fengecho/electronic/README.md

All work in this repository is under the license bsd available [here] (https://github.com/echopen/electronic/blob/master/LICENSE)

# electronic

This repository is dedicated to the electronic part. The electronic shemas of the modules printed with kicad can be found in the kicad repository
