fengecho/electronic/Mecanics/Readme.md

In this repository one can find the sources of mecanical parts we have printed in order to make a experimental device with an aquarium.
