fengecho/electronic/kicad/Daugter_boards/DB_Envelope_detector/V2/Scheme.png

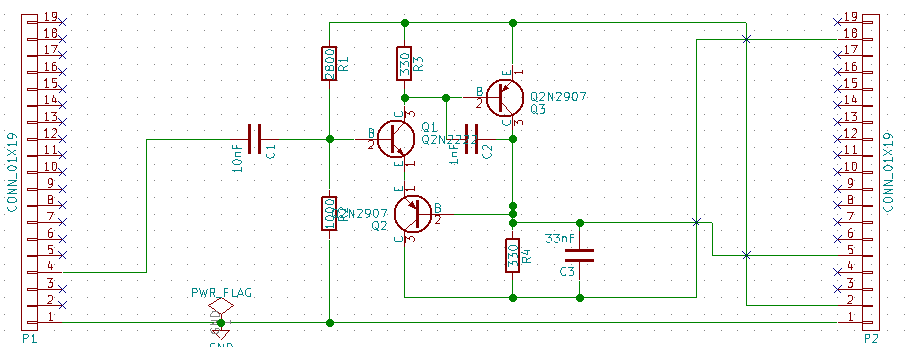
kicad/Daugter_boards/DB_Envelope_detector/V2/Scheme.png
