fengecho/electronic/kicad/Daugter_boards/DB_Filter/V2/Scheme.png

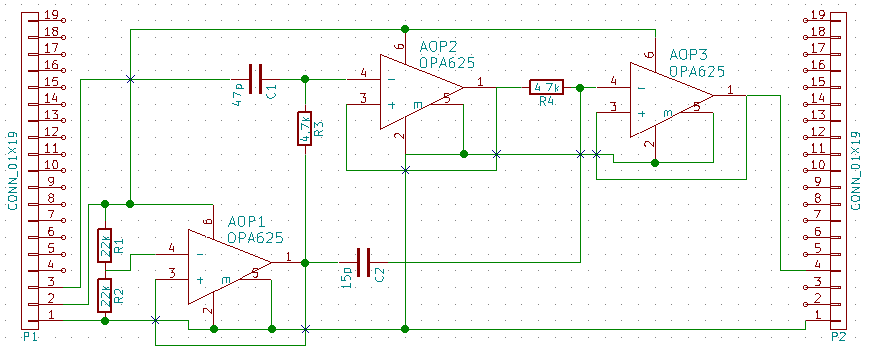
kicad/Daugter_boards/DB_Filter/V2/Scheme.png
