fengecho/electronic/kicad/Daugter_boards/DB_High_Voltage/V2/PCB.png

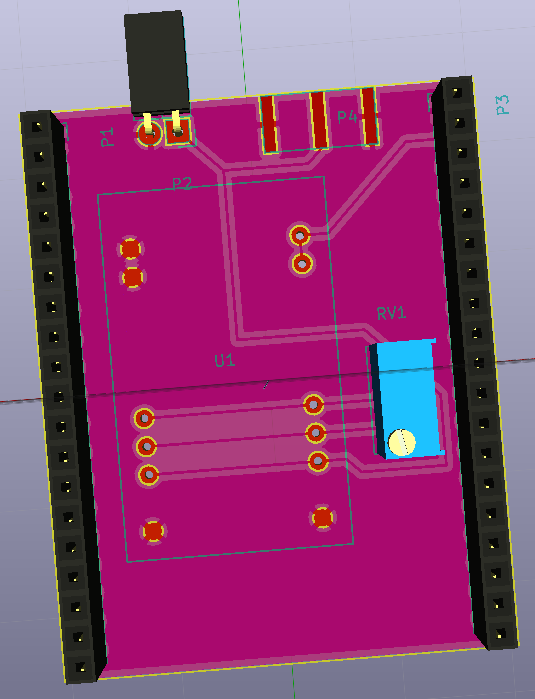
kicad/Daugter_boards/DB_High_Voltage/V2/PCB.png
