fengecho/electronic/kicad/Daugter_boards/DB_High_Voltage/V2/Scheme.png

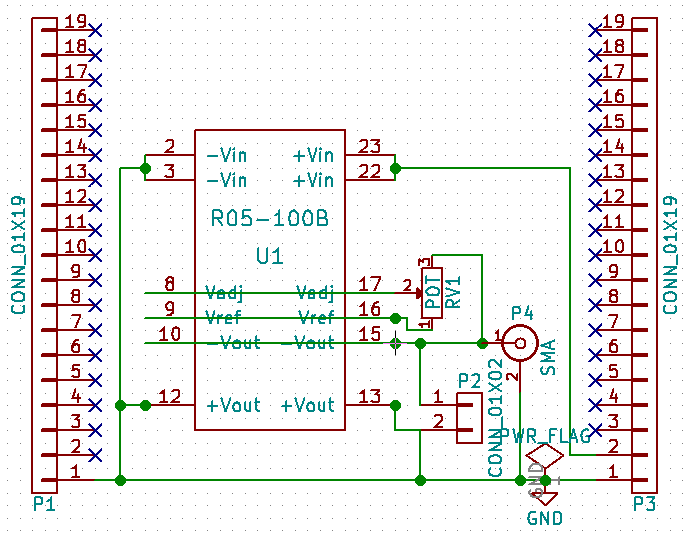
kicad/Daugter_boards/DB_High_Voltage/V2/Scheme.png
