fengecho/electronic/kicad/Daugter_boards/DB_Motor_control/V2/PCB.png

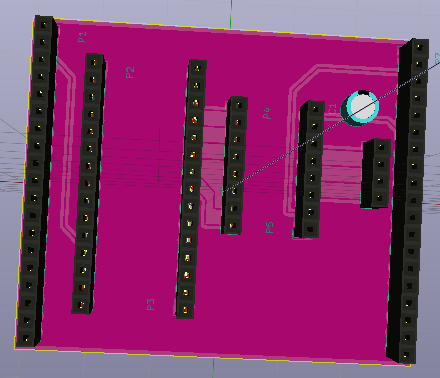
kicad/Daugter_boards/DB_Motor_control/V2/PCB.png
