fengecho/electronic/kicad/Daugter_boards/DB_Motor_control/V2/Scheme.png

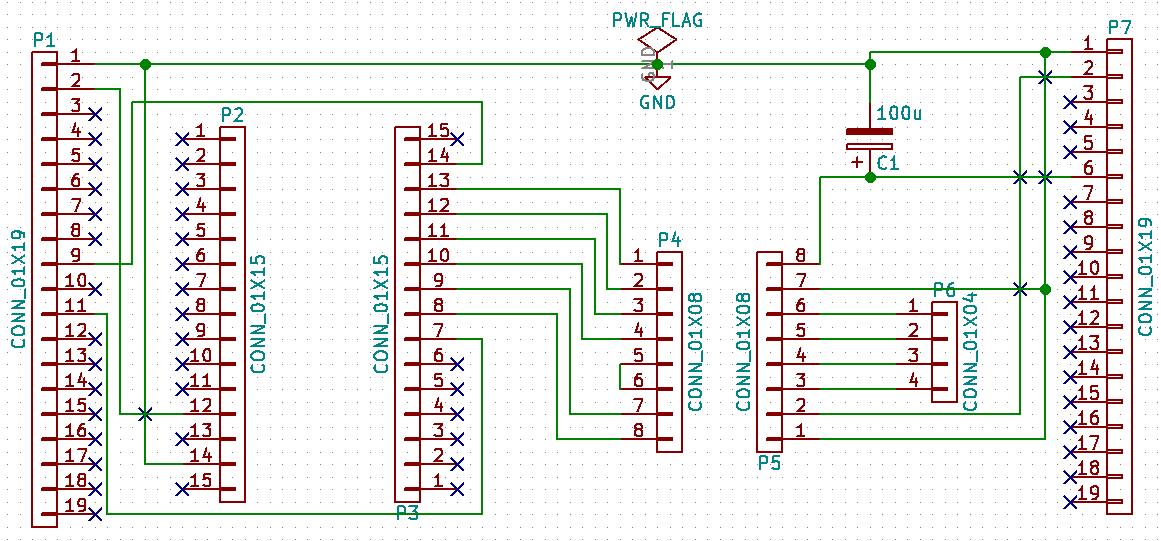
kicad/Daugter_boards/DB_Motor_control/V2/Scheme.png
