fengecho/electronic/kicad/Daugter_boards/DB_Supply/V2/Scheme.png

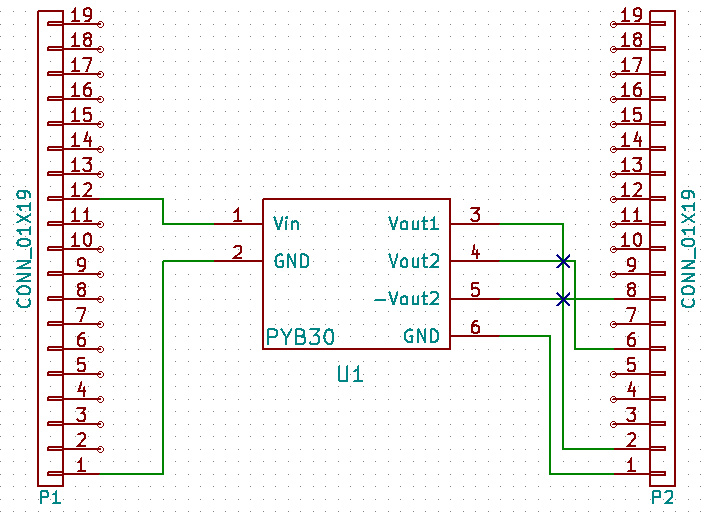
kicad/Daugter_boards/DB_Supply/V2/Scheme.png
