fengecho/electronic/kicad/Daugter_boards/DB_TR_switch_TGC/V1/Scheme.png

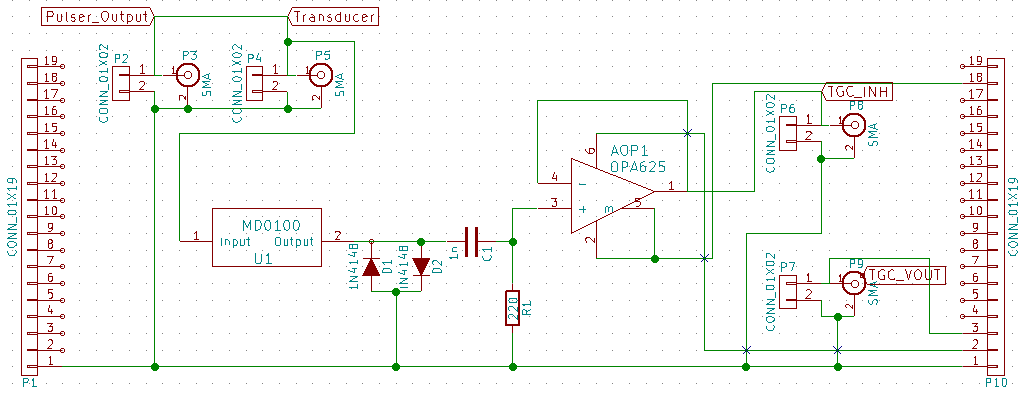
kicad/Daugter_boards/DB_TR_switch_TGC/V1/Scheme.png
