fengecho/electronic/kicad/Modules/MDL_Envelope_detector/V2/Scheme.png

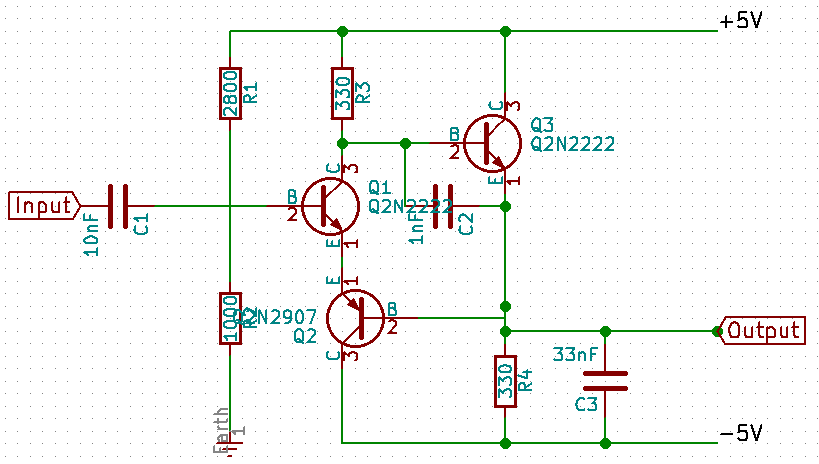
kicad/Modules/MDL_Envelope_detector/V2/Scheme.png
