fengecho/electronic/kicad/Modules/MDL_Filter/V2/Scheme.png

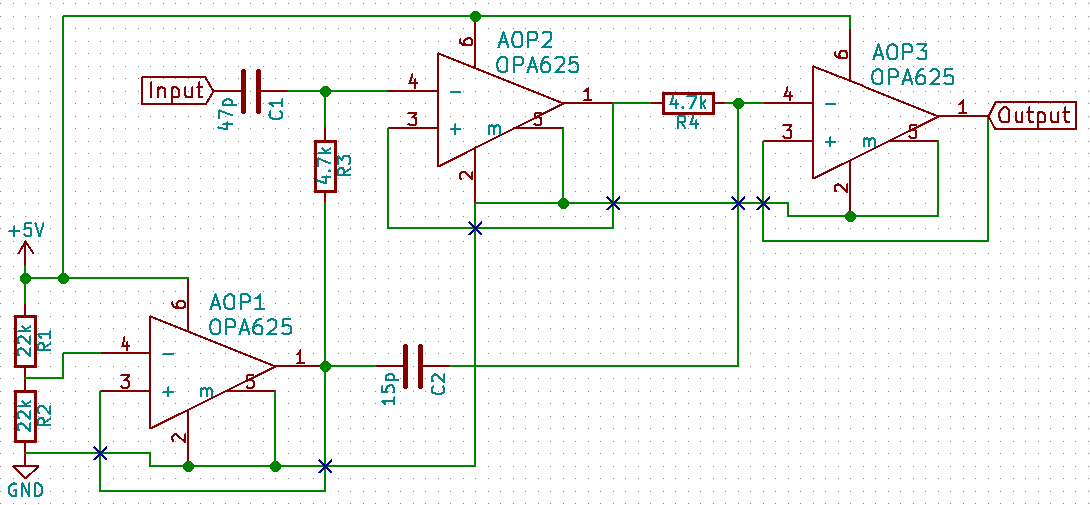
kicad/Modules/MDL_Filter/V2/Scheme.png
