fengecho/electronic/kicad/Modules/MDL_High_Voltage_Circuit/V2/Scheme.png

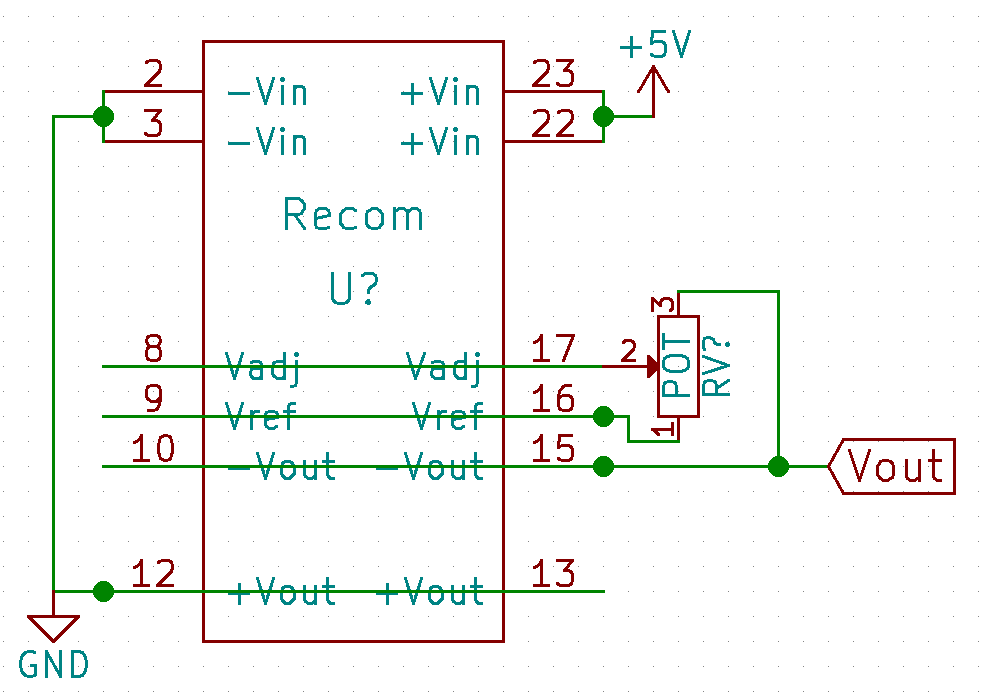
kicad/Modules/MDL_High_Voltage_Circuit/V2/Scheme.png
