fengecho/electronic/kicad/Modules/MDL_Motor_control/V2/Scheme.png

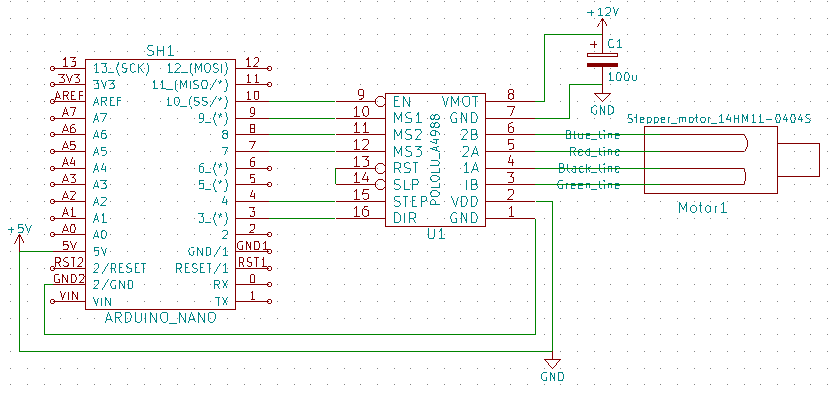
kicad/Modules/MDL_Motor_control/V2/Scheme.png
