fengecho/electronic/kicad/Modules/MDL_Pulser/V2/Scheme.png

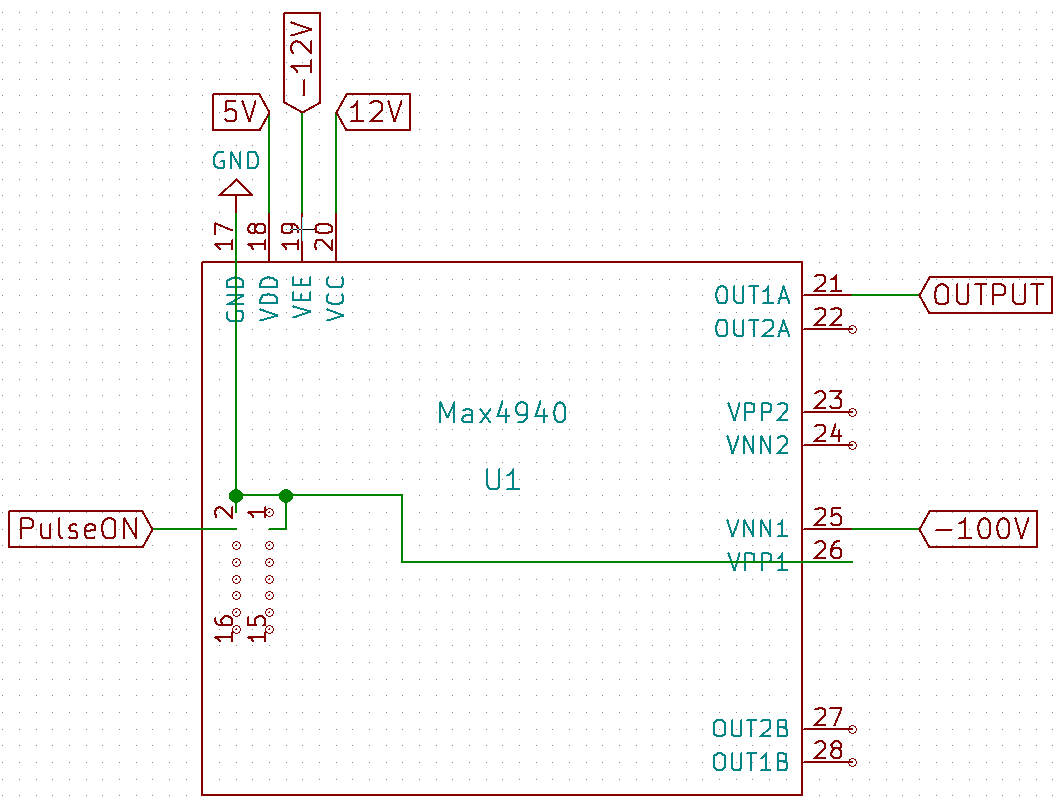
kicad/Modules/MDL_Pulser/V2/Scheme.png
