fengecho/electronic/kicad/Modules/MDL_Ramp/MDL_Ramp_V2/Scheme.png

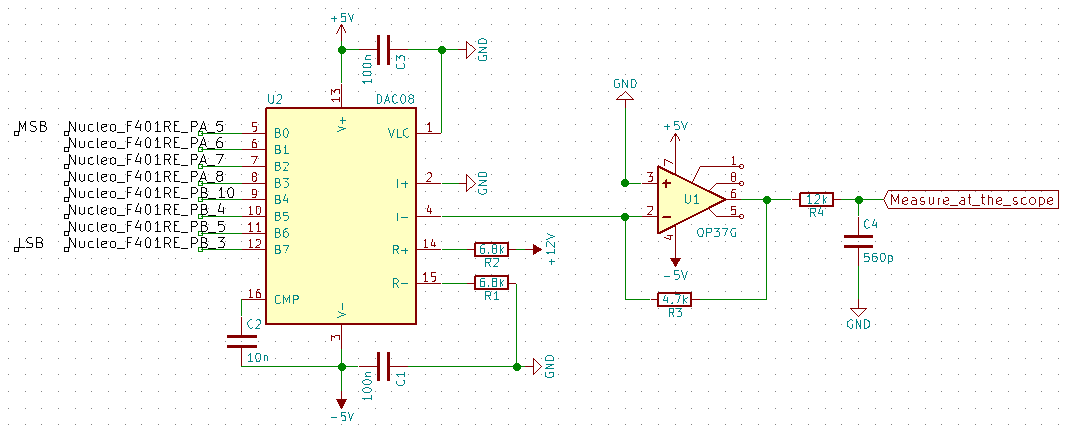
kicad/Modules/MDL_Ramp/MDL_Ramp_V2/Scheme.png
