fengecho/electronic/kicad/Modules/MDL_Ramp/Ramp_Generator_FPGA/Scheme.png

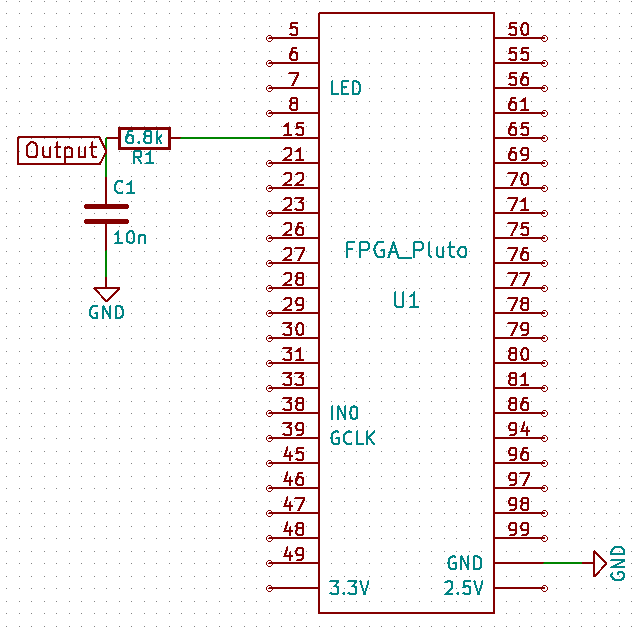
kicad/Modules/MDL_Ramp/Ramp_Generator_FPGA/Scheme.png
