fengecho/electronic/kicad/Modules/MDL_Ramp/Ramp_generator_FPGA_and_DAC_module/scheme.png

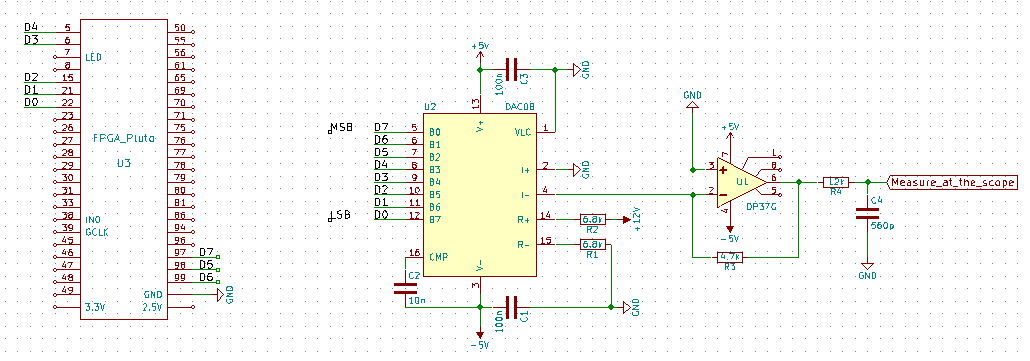
kicad/Modules/MDL_Ramp/Ramp_generator_FPGA_and_DAC_module/scheme.png
