fengecho/electronic/kicad/Modules/MDL_Ramp/Simple_Ramp_Generator_FPGA/Scheme.png

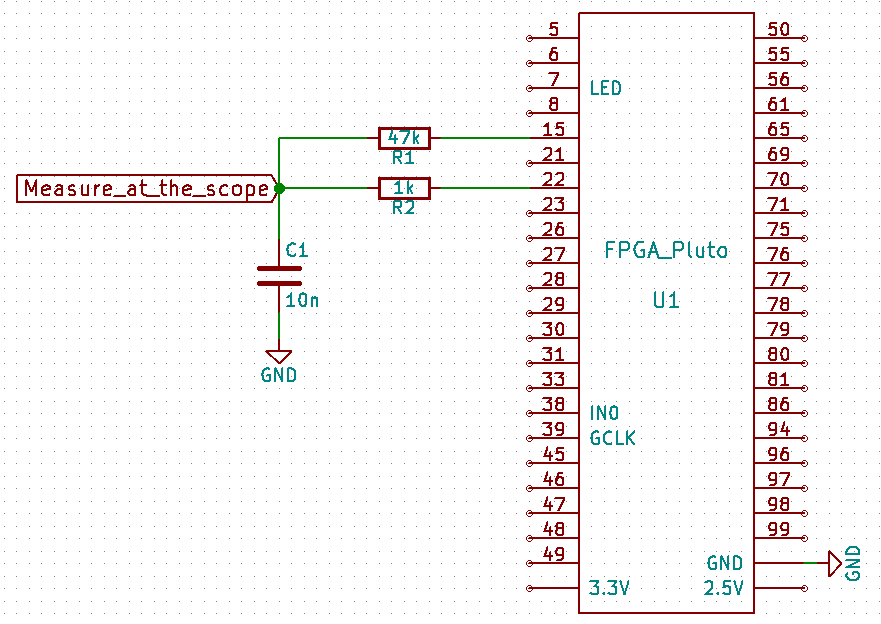
kicad/Modules/MDL_Ramp/Simple_Ramp_Generator_FPGA/Scheme.png
