fengecho/electronic/kicad/Modules/MDL_Supply/V2/Scheme.png

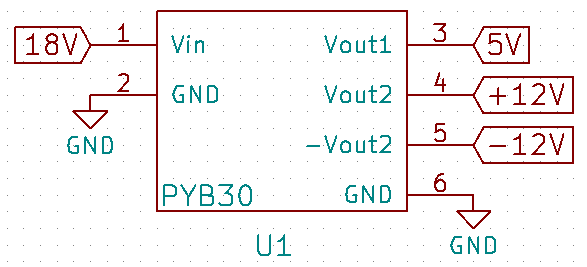
kicad/Modules/MDL_Supply/V2/Scheme.png
