fengecho/electronic/kicad/Modules/MDL_TGC/V1/Scheme.png

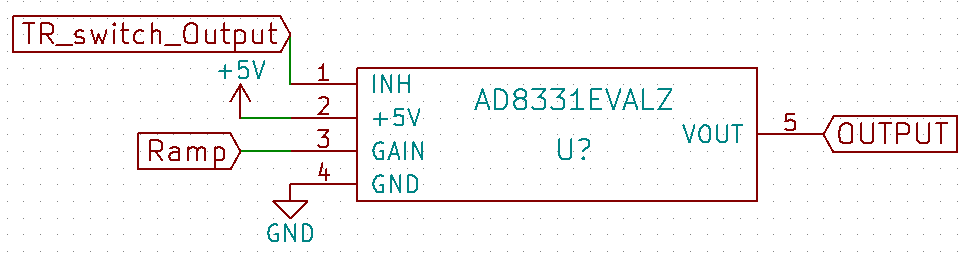
kicad/Modules/MDL_TGC/V1/Scheme.png
