fengecho/electronic/kicad/Modules/MDL_TR_switch/V1/Scheme.png

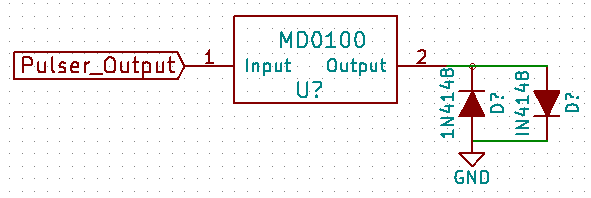
kicad/Modules/MDL_TR_switch/V1/Scheme.png
