fengecho/electronic/kicad/Modules/MDL_ucontroler/V1/Scheme.png

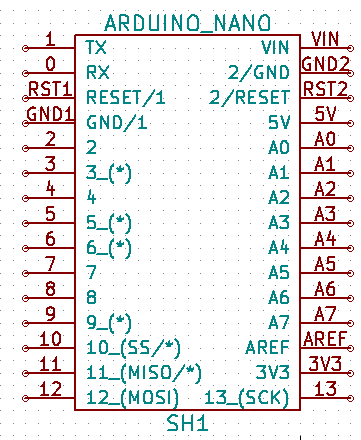
kicad/Modules/MDL_ucontroler/V1/Scheme.png
