fengecho/electronic/Sofware/Modules/MDL_ADC/V1/MDL_ADC_V1.png

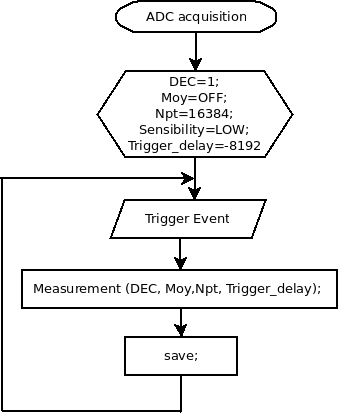
Sofware/Modules/MDL_ADC/V1/MDL_ADC_V1.png
