fengecho/electronic/Sofware/Modules/MDL_Motor_Control/V2/MDL_Motor_Control_V2.png

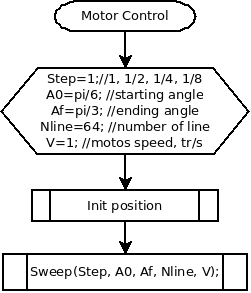
Sofware/Modules/MDL_Motor_Control/V2/MDL_Motor_Control_V2.png
