fengecho/electronic/Sofware/Modules/MDL_Ramp/V1/MDL_Ramp_V1.png

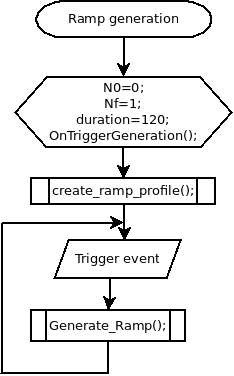
Sofware/Modules/MDL_Ramp/V1/MDL_Ramp_V1.png
