fengecho/electronic/Sofware/Modules/MDL_ucontroler/Main.png

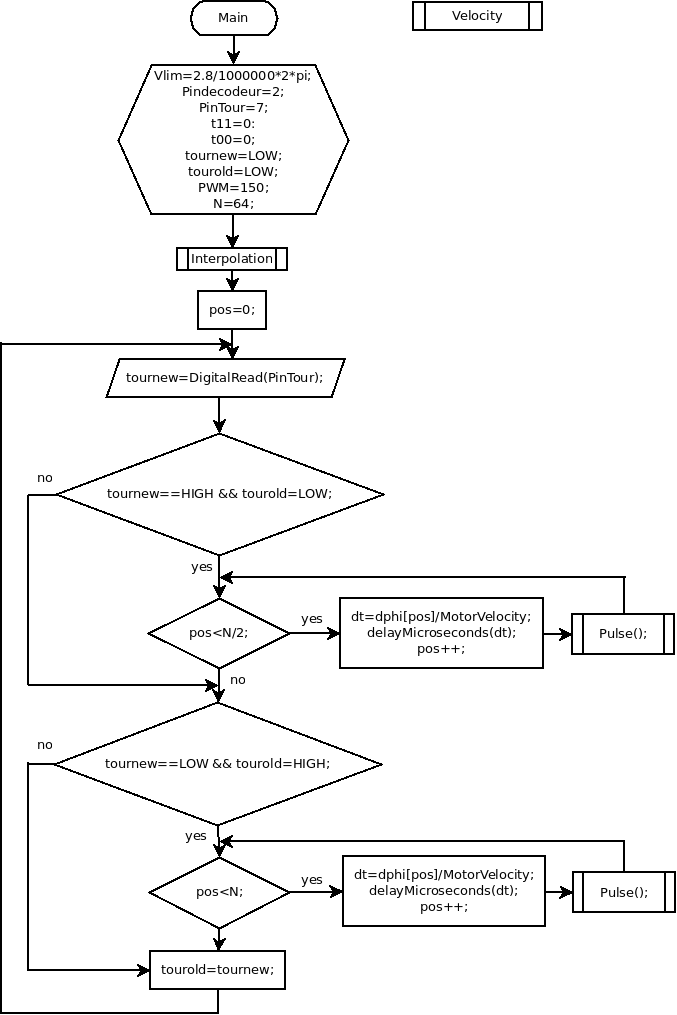
Sofware/Modules/MDL_ucontroler/Main.png
