fengecho/electronic/kicad/Daugter_boards/DB_Mother_Board/DB_Mother_Board.csv

Source | /home/echopen/Bureau/GitHub/electronic/kicad/Daugter_boards/DB_Link/DB_Link.sch
Kicad Rev | Eeschema 4.0.3+e1-6302~38~ubuntu16.04.1-stable
Generated Date | mar. 16 août 2016 18:55:56 CEST
Title | Not Set
Company | Not Set
Revision | Not Set
Date Issue | Not Set
Reference | Value | Library | Library Ref
P1 | CONN_01X19 | conn | CONN_01X19
P2 | CONN_01X19 | conn | CONN_01X19
