fengecho/electronic/kicad/Modules/MDL_Motor_control/V2/motor project.csv

Source | /home/echopen/Bureau/GitHub/electronic/kicad/Modules/MDL_Motor_control/V2/motor project.sch
Kicad Rev | Eeschema 4.0.3+e1-6302~38~ubuntu16.04.1-stable
Generated Date | mar. 09 août 2016 11:18:45 CEST
Title | Not Set
Company | Not Set
Revision | Not Set
Date Issue | Not Set
Reference | Value | Library | Library Ref
U1 | POLOLU_A4988 | echopen | POLOLU_A4988
SH1 | ARDUINO_NANO | echopen | ARDUINO_NANO
Motor1 | Stepper_motor_14HM11-0404S | echopen | Stepper_motor_14HM11-0404S
C1 | 100u | device | CP
