fengecho/electronic/kicad/Modules/MDL_Pulser/V2/MDL_Pulser_V2.csv

Source | /home/echopen/Bureau/GitHub/electronic/kicad/Modules/MDL_Pulser/V2/MDL_Pulser_V2.sch
Kicad Rev | Eeschema 4.0.3+e1-6302~38~ubuntu16.04.1-stable
Generated Date | mar. 09 août 2016 09:50:04 CEST
Title | Not Set
Company | Not Set
Revision | Not Set
Date Issue | Not Set
Reference | Value | Library | Library Ref
U1 | Max4940 | echopen | Max4940
