fengecho/electronic/kicad/Modules/MDL_Supply/V2/MDl_Supply_V2.csv

Source | /home/echopen/Bureau/GitHub/electronic/kicad/Modules/MDL_Supply/V2/MDl_Supply_V2.sch
Kicad Rev | Eeschema 4.0.3+e1-6302~38~ubuntu16.04.1-stable
Generated Date | lun. 08 août 2016 10:46:09 CEST
Title | Not Set
Company | Not Set
Revision | Not Set
Date Issue | Not Set
Reference | Value | Library | Library Ref
U1 | PYB30 | echopen | PYB30
