fengecho/electronic/kicad/Modules/MDL_TGC/V1/MDL_TGC_V1.csv

Source | /home/echopen/Bureau/GitHub/electronic/kicad/Modules/MDL_TGC/V1/MDL_TGC_V1.sch
Kicad Rev | Eeschema 4.0.2+e4-6225~38~ubuntu16.04.1-stable
Generated Date | ven. 05 août 2016 13:19:30 CEST
Title | Not Set
Company | Not Set
Revision | Not Set
Date Issue | Not Set
Reference | Value | Library | Library Ref
U1 | AD8331EVALZ | echopen | AD8331EVALZ
