fengecho/electronic/kicad/Modules/MDL_High_Voltage_Circuit/V2/MDL_HVC_V2.csv

Source | /home/echopen/Bureau/GitHub/electronic/kicad/Modules/MDL_High_Voltage_Circuit/V2/MDL_HVC_V2.sch
Kicad Rev | Eeschema 4.0.2+e4-6225~38~ubuntu16.04.1-stable
Generated Date | jeu. 04 août 2016 11:46:50 CEST
Title | Not Set
Company | Not Set
Revision | Not Set
Date Issue | Not Set
Reference | Value | Library | Library Ref
U1 | Recom | recom | Recom
RV1 | POT | device | POT
