fengecho/electronic/Mecanics/3D_Printing_source/3D_Printing_source_for_prototype/demonstration_with_all_components/demonstration_with_all_components_02.png

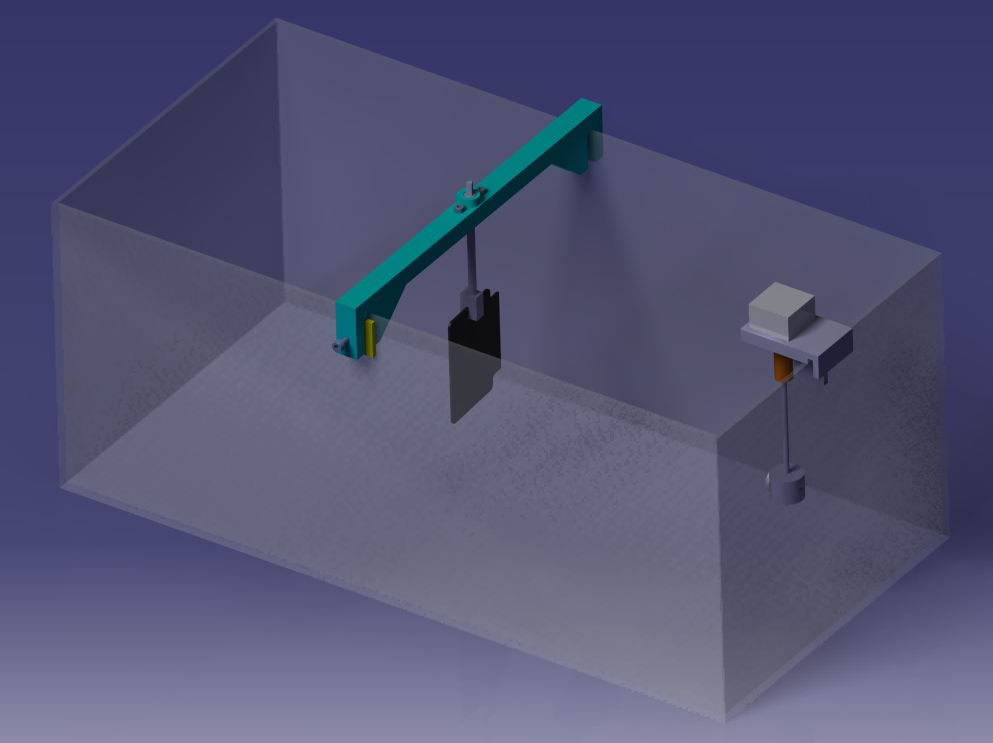
Mecanics/3D_Printing_source/3D_Printing_source_for_prototype/demonstration_with_all_components/demonstration_with_all_components_02.png
