fengecho/electronic/Mecanics/3D_Printing_source/3D_Printing_source_for_prototype/beam/beam_b.igs

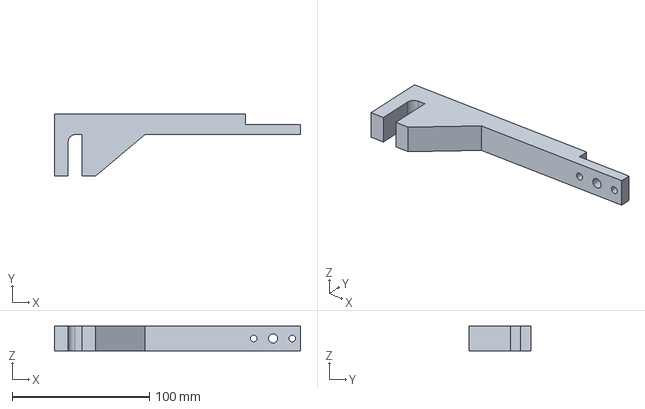
[picture p30: CAD file, 2016-08-18]
Mecanics/3D_Printing_source/3D_Printing_source_for_prototype/beam/beam_b.igs
179.0 x 45.0 x 18.0 mm
