fengecho/electronic/Mecanics/3D_Printing_source/3D_Printing_source_for_prototype/demonstration_with_all_components/demonstration_with_all_components.igs

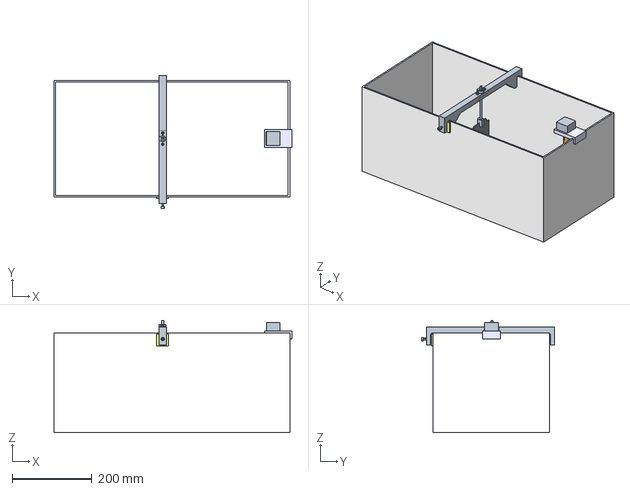
[picture p31: CAD file, 2016-08-18]
Mecanics/3D_Printing_source/3D_Printing_source_for_prototype/demonstration_with_all_components/demonstration_with_all_components.igs
597.5 x 334.6 x 282.0 mm
