fengecho/electronic/Mecanics/3D_Printing_source/3D_Printing_source_for_prototype/joint_between_motor_and_metal_rod/joint_between_motor_and_metal_rod.igs

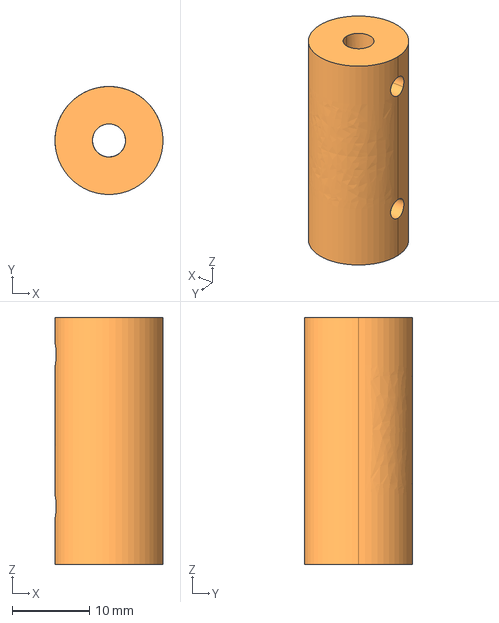
[picture p32: CAD file, 2016-08-18]
Mecanics/3D_Printing_source/3D_Printing_source_for_prototype/joint_between_motor_and_metal_rod/joint_between_motor_and_metal_rod.igs
14.0 x 14.0 x 32.0 mm
