fengecho/electronic/Mecanics/3D_Printing_source/3D_Printing_source_for_prototype/metal_plate_support/metal_plate_support02.igs

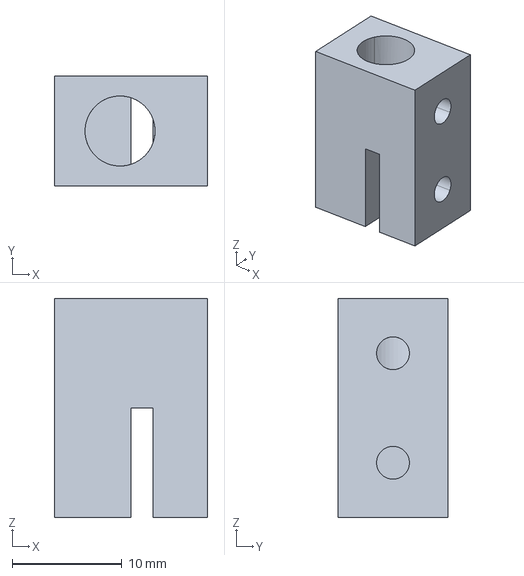
[picture p33: CAD file, 2016-08-18]
Mecanics/3D_Printing_source/3D_Printing_source_for_prototype/metal_plate_support/metal_plate_support02.igs
14.0 x 10.0 x 20.0 mm
