fengecho/electronic/Mecanics/3D_Printing_source/3D_Printing_source_for_prototype/motor_support/motor_support.igs

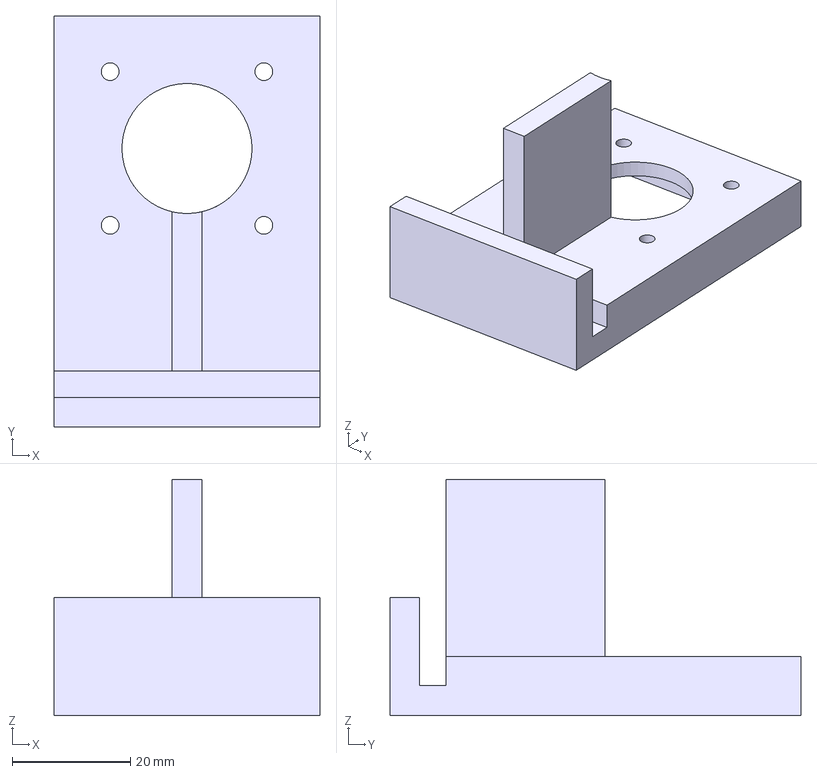
[picture p34: CAD file, 2016-08-18]
Mecanics/3D_Printing_source/3D_Printing_source_for_prototype/motor_support/motor_support.igs
45.0 x 69.5 x 40.0 mm
