fengecho/electronic/Mecanics/3D_Printing_source/3D_Printing_source_for_prototype/transducer_support/transducer_support.igs

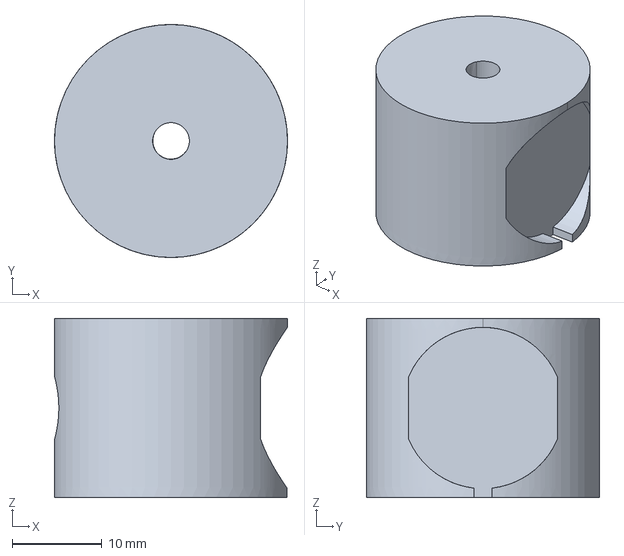
[picture p35: CAD file, 2016-08-18]
Mecanics/3D_Printing_source/3D_Printing_source_for_prototype/transducer_support/transducer_support.igs
26.0 x 26.0 x 20.0 mm
