fengecho/electronic/Mecanics/3D_Printing_source/gyroscope_MPU6050_support/gyroscope_support_b.igs

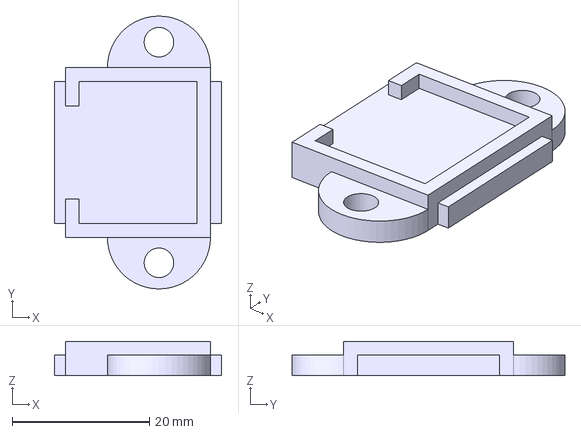
[picture p36: CAD file, 2016-08-18]
Mecanics/3D_Printing_source/gyroscope_MPU6050_support/gyroscope_support_b.igs
24.3 x 39.7 x 5.00 mm
