fengecho/electronic/Mecanics/3D_Printing_source/3D_Printing_source_for_prototype/beam/beam_a.igs

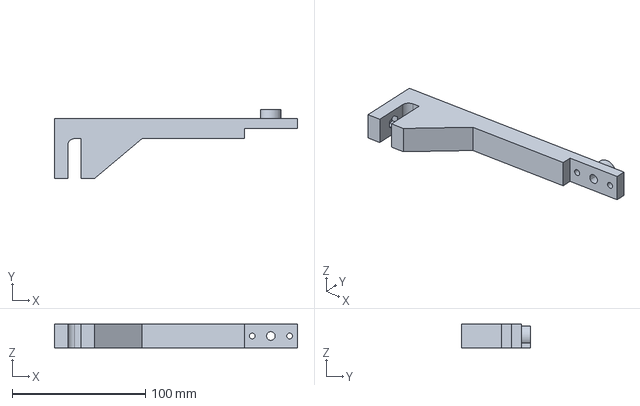
[picture p37: CAD file, 2016-08-18]
Mecanics/3D_Printing_source/3D_Printing_source_for_prototype/beam/beam_a.igs
182.6 x 52.0 x 18.0 mm
