fengecho/electronic/Mecanics/3D_Printing_source/3D_Printing_source_for_prototype/metal_plate_support/metal_plate_support01.igs

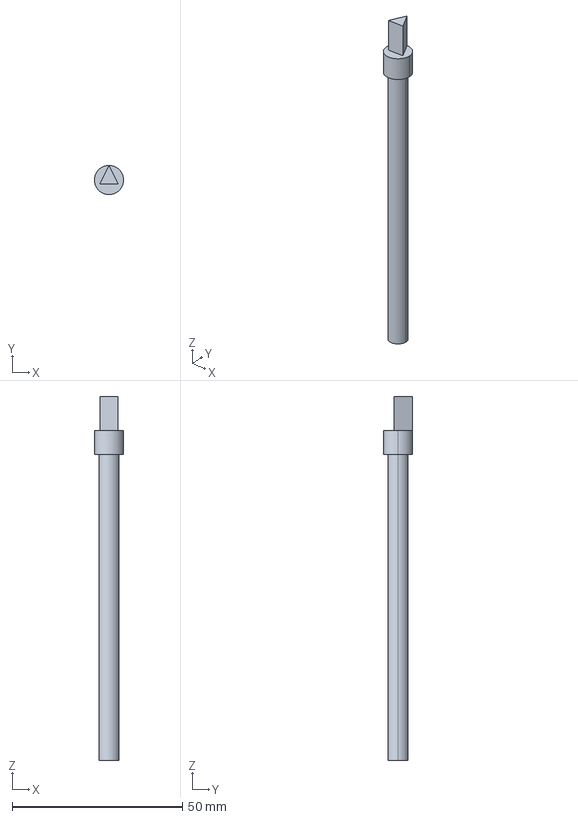
[picture p38: CAD file, 2016-08-18]
Mecanics/3D_Printing_source/3D_Printing_source_for_prototype/metal_plate_support/metal_plate_support01.igs
8.60 x 8.60 x 107.0 mm
