fengecho/electronic/Mecanics/3D_Printing_source/gyroscope_MPU6050_support/gyroscope_support_a.igs

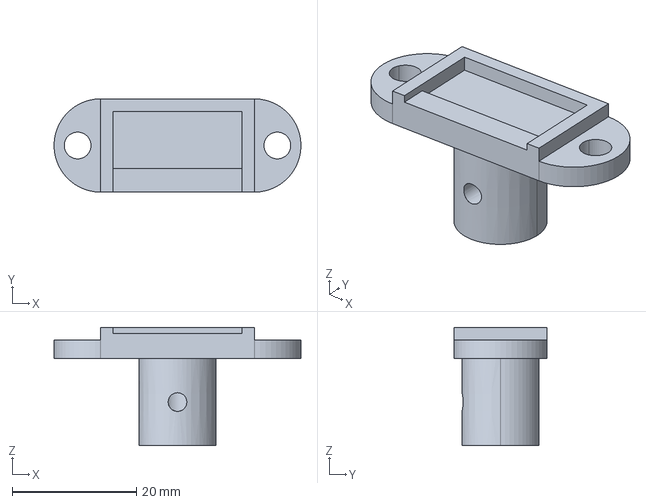
[picture p39: CAD file, 2016-08-18]
Mecanics/3D_Printing_source/gyroscope_MPU6050_support/gyroscope_support_a.igs
39.7 x 15.0 x 19.0 mm
