fengecho/electronic/Mecanics/3D_Printing_source/3D_Printing_source_for_prototype/beam/beam_a.png

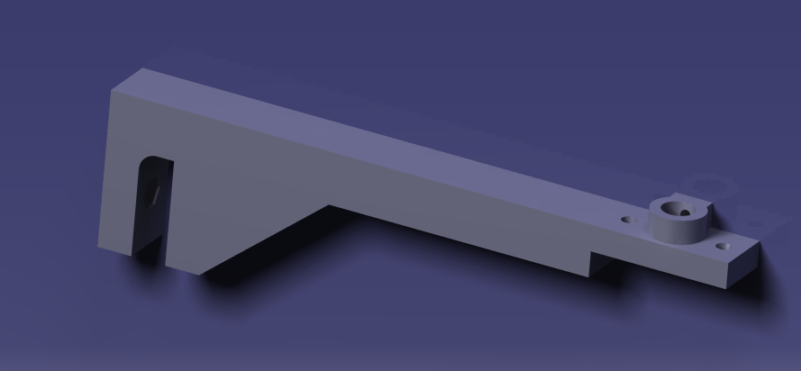
Mecanics/3D_Printing_source/3D_Printing_source_for_prototype/beam/beam_a.png
