fengecho/electronic/Mecanics/3D_Printing_source/3D_Printing_source_for_prototype/joint_between_motor_and_metal_rod/joint_between_motor_and_metal_rod.png

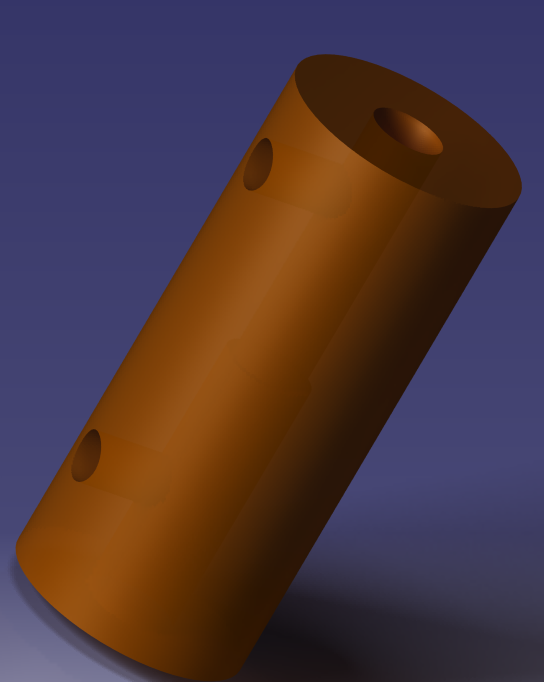
Mecanics/3D_Printing_source/3D_Printing_source_for_prototype/joint_between_motor_and_metal_rod/joint_between_motor_and_metal_rod.png
