fengecho/electronic/Mecanics/3D_Printing_source/3D_Printing_source_for_prototype/metal_plate_support/metal_plate_support02.png

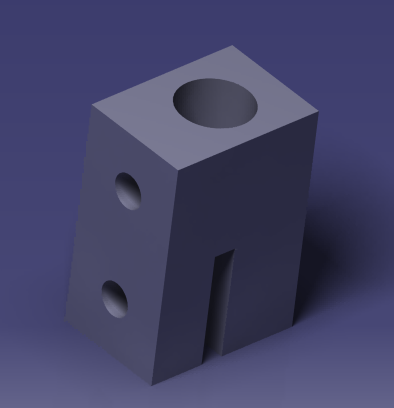
Mecanics/3D_Printing_source/3D_Printing_source_for_prototype/metal_plate_support/metal_plate_support02.png
