fengecho/electronic/Mecanics/3D_Printing_source/3D_Printing_source_for_prototype/transducer_support/transducer_support.png

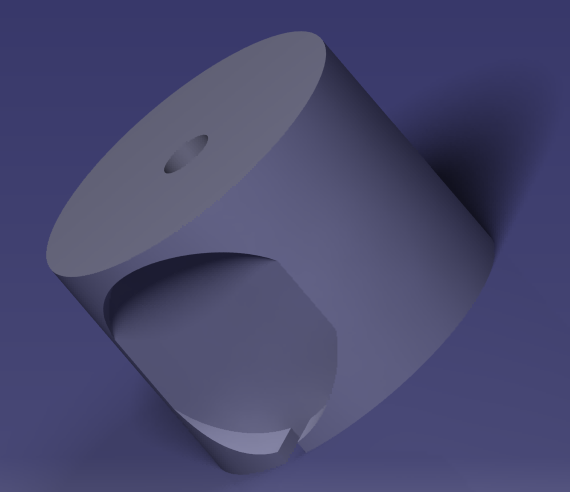
Mecanics/3D_Printing_source/3D_Printing_source_for_prototype/transducer_support/transducer_support.png
