fengecho/electronic/Mecanics/3D_Printing_source/gyroscope_MPU6050_support/demonstration.png

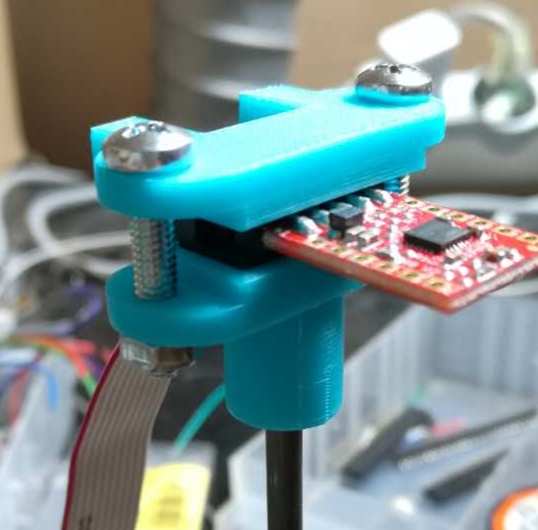
Mecanics/3D_Printing_source/gyroscope_MPU6050_support/demonstration.png
