fengecho/electronic/Mecanics/3D_Printing_source/gyroscope_MPU6050_support/gyroscope_support_b.png

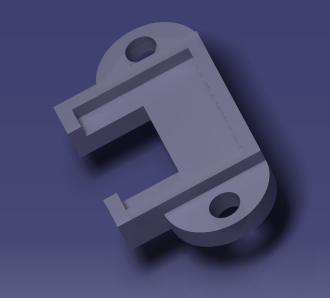
Mecanics/3D_Printing_source/gyroscope_MPU6050_support/gyroscope_support_b.png
