fengecho/electronic/kicad/Daugter_boards/DB_High_Voltage/V2/DB_HV_V2.kicad_pcb

## KiCad design kicad/Daugter_boards/DB_High_Voltage/V2/DB_HV_V2.kicad_pcb (2016-08-18)

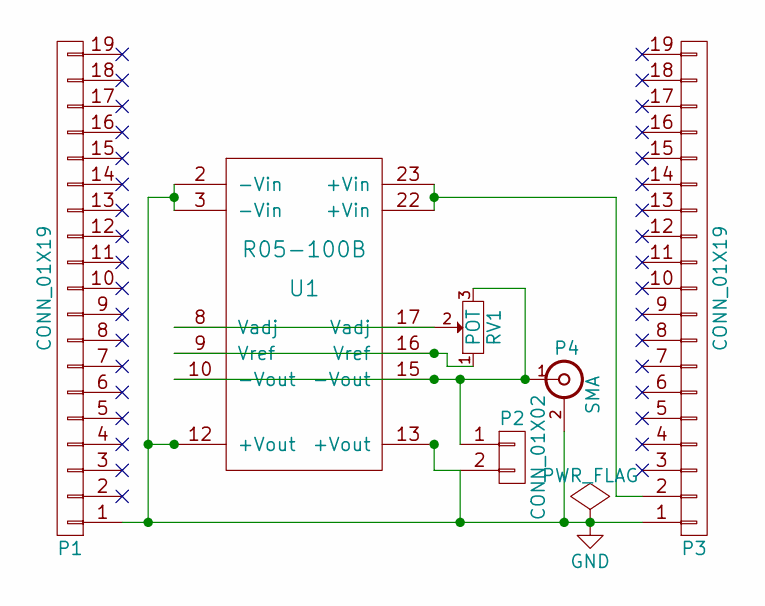
[picture p49: schematic DB_HV_V2.sch]

Parts:
P1, P3: CONN_01X19; Socket_Strip_Straight_1x19
P2: CONN_01X02; Socket_Strip_Angled_1x02
P4: SMA; BNC_Socket_TYCO-AMP_LargePads
RV1: POT; Potentiometer_Bourns_3296Y_3-8Zoll_Angular_ScrewUp
U1: R05-100B; DCDC-Conv_TRACO_TED-1212_Single_9-18VDCto12VDC160mA

Connections:
GND: P1.1, P2.2, P3.1, P4.2 (Ext), U1.2 (-Vin), U1.3 (-Vin), U1.12 (+Vout), U1.13 (+Vout)
unnamed: P2.1, P4.1 (In), RV1.3, U1.10 (-Vout), U1.15 (-Vout)
unnamed: P3.2, U1.22 (+Vin), U1.23 (+Vin)
unnamed: RV1.1, U1.9 (Vref), U1.16 (Vref)
unnamed: RV1.2, U1.8 (Vadj), U1.17 (Vadj)

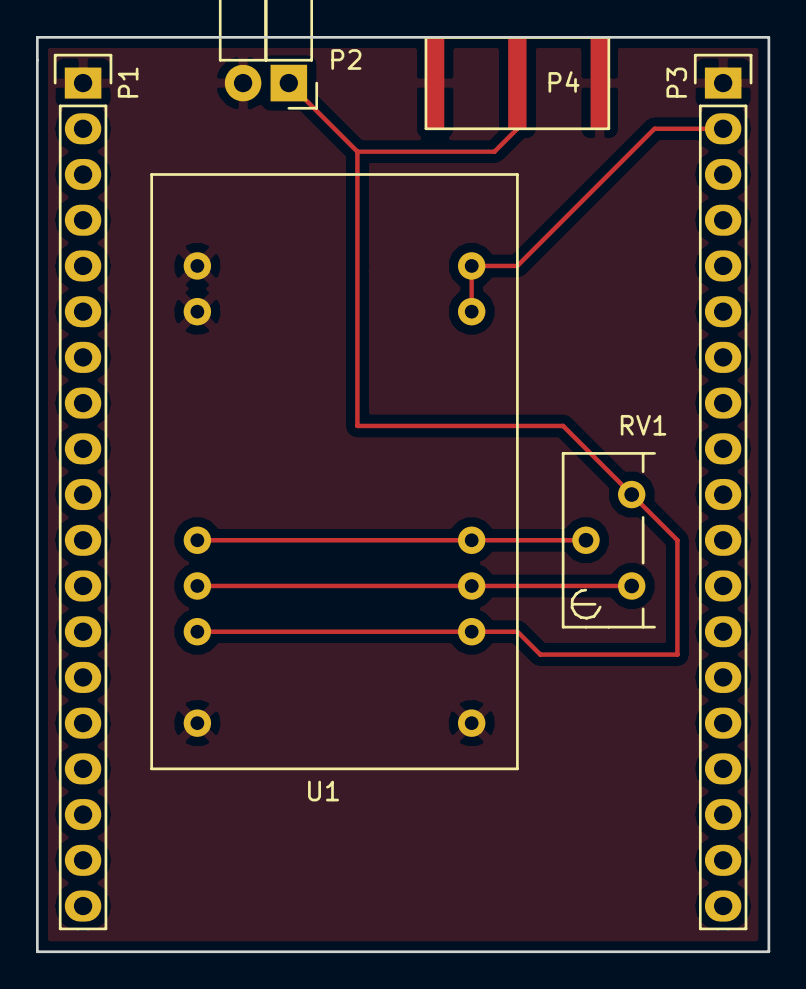
[picture p50: board DB_HV_V2.kicad_pcb from above]

Board: 2 copper layers, 40.6 x 50.8 mm, 6 parts (0 on the bottom side), 5 nets.
