fengecho/electronic/kicad/Daugter_boards/DB_Filter/V1/DB_Filter_V1.kicad_pcb

## KiCad design kicad/Daugter_boards/DB_Filter/V1/DB_Filter_V1.kicad_pcb (2016-08-18, an earlier design)

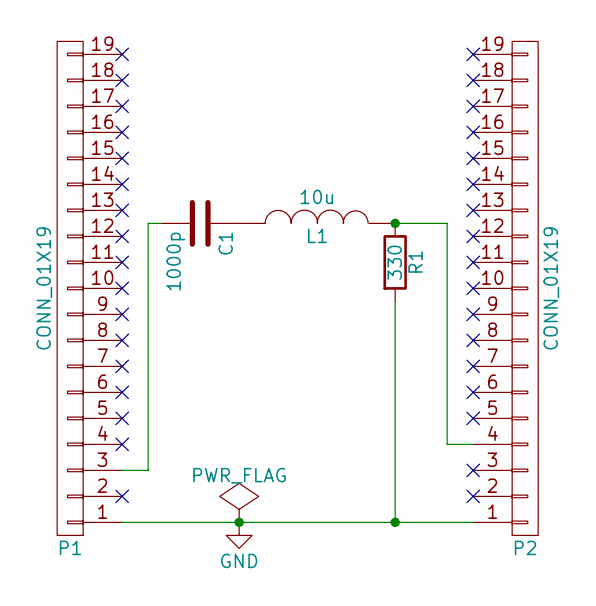
[picture p51: schematic DB_Filter_V1.sch]

Parts:
C1: 1000p; C_Disc_D6_P5
L1: 10u; INDUCTOR_V
P1, P2: CONN_01X19; Socket_Strip_Straight_1x19
R1: 330; Resistor_Horizontal_RM7mm

Connections:
GND: P1.1, P2.1, R1.2
unnamed: C1.1, L1.2
unnamed: C1.2, P1.3
unnamed: L1.1, P2.4, R1.1

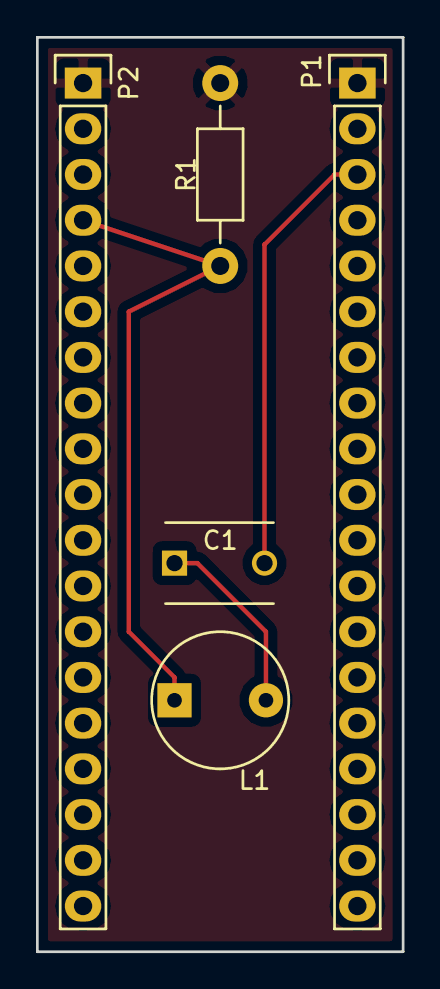
[picture p52: board DB_Filter_V1.kicad_pcb from above]

Board: 2 copper layers, 20.3 x 50.8 mm, 5 parts (0 on the bottom side), 4 nets.
