fengecho/electronic/kicad/Daugter_boards/DB_High_Voltage/V1/DB_HV_V1.kicad_pcb

## KiCad design kicad/Daugter_boards/DB_High_Voltage/V1/DB_HV_V1.kicad_pcb (2016-08-18, an earlier design)

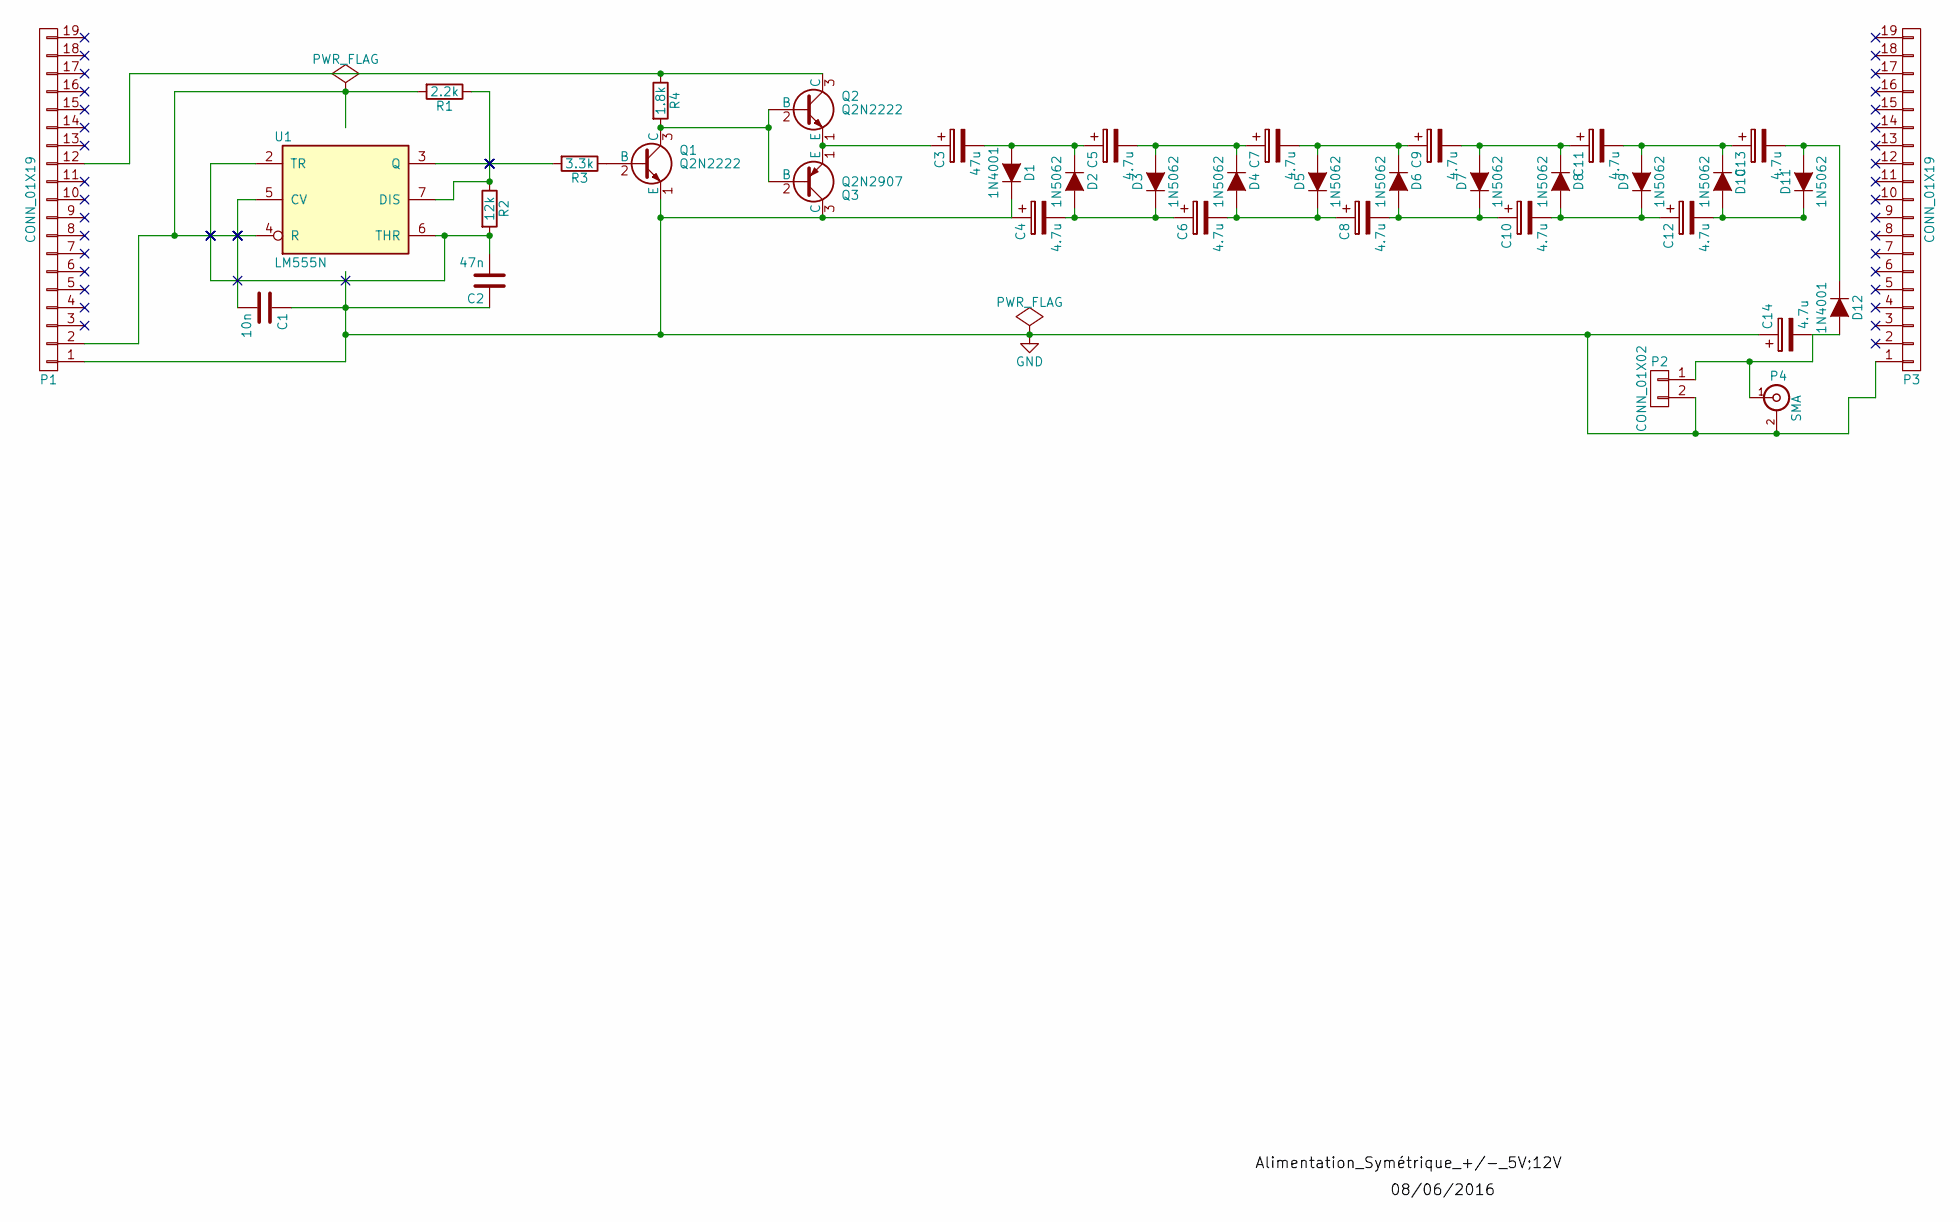
[picture p53: schematic DB_HV_V1.sch]

Parts:
C1: 10n; C_Disc_D7.5_P5
C2: 47n; C_Disc_D7.5_P5
C3: 47u; CP36V
C4, C5, C6, C7, C8, C9, C10, C11, C12, C13, C14: 4.7u; CP36V
D1, D12: 1N4001; Diode_DO-35_SOD27_Horizontal_RM10
D2, D3, D4, D5, D6, D7, D8, D9, D10, D11: 1N5062; Diode_DO-35_SOD27_Horizontal_RM10
P1, P3: CONN_01X19; Socket_Strip_Straight_1x19
P2: CONN_01X02; Socket_Strip_Straight_1x02
P4: SMA; BNC_Socket_TYCO-AMP
Q1, Q2: Q2N2222; TO-18_3Pin
Q3: Q2N2907; TO-18_3Pin
R1: 2.2k; Resistor_Horizontal_RM10mm
R2: 12k; Resistor_Horizontal_RM10mm
R3: 3.3k; Resistor_Horizontal_RM10mm
R4: 1.8k; Resistor_Horizontal_RM10mm
U1: LM555N; DIP-8_W7.62mm

Connections:
GND: C1.1, C2.1, C4.1, C14.1, D1.1 (K), P1.1, P2.2, P3.1, P4.2 (Ext), Q1.1 (E), Q3.3 (C), U1.1 (GND)
unnamed: C1.2, U1.5 (CV)
unnamed: C2.2, R2.2, U1.2 (TR), U1.6 (THR)
unnamed: C3.1, Q2.1 (E), Q3.1 (E)
unnamed: C3.2, C5.1, D1.2 (A), D2.1 (K)
unnamed: C4.2, C6.1, D2.2 (A), D3.1 (K)
unnamed: C5.2, C7.1, D3.2 (A), D4.1 (K)
unnamed: C6.2, C8.1, D4.2 (A), D5.1 (K)
unnamed: C7.2, C9.1, D5.2 (A), D6.1 (K)
unnamed: C8.2, C10.1, D6.2 (A), D7.1 (K)
unnamed: C10.2, C12.1, D8.2 (A), D9.1 (K)
unnamed: C9.2, C11.1, D7.2 (A), D8.1 (K)
unnamed: C11.2, C13.1, D9.2 (A), D10.1 (K)
unnamed: C12.2, D10.2 (A), D11.1 (K)
unnamed: C13.2, D11.2 (A), D12.1 (K)
unnamed: C14.2, D12.2 (A), P2.1, P4.1 (In)
unnamed: P1.12, Q2.3 (C), R4.1
unnamed: Q1.2 (B), R3.1
unnamed: Q1.3 (C), Q2.2 (B), Q3.2 (B), R4.2
unnamed: R1.1, R2.1, U1.7 (DIS)
unnamed: R3.2, U1.3 (Q)
VCC: P1.2, R1.2, U1.4 (R), U1.8 (VCC)

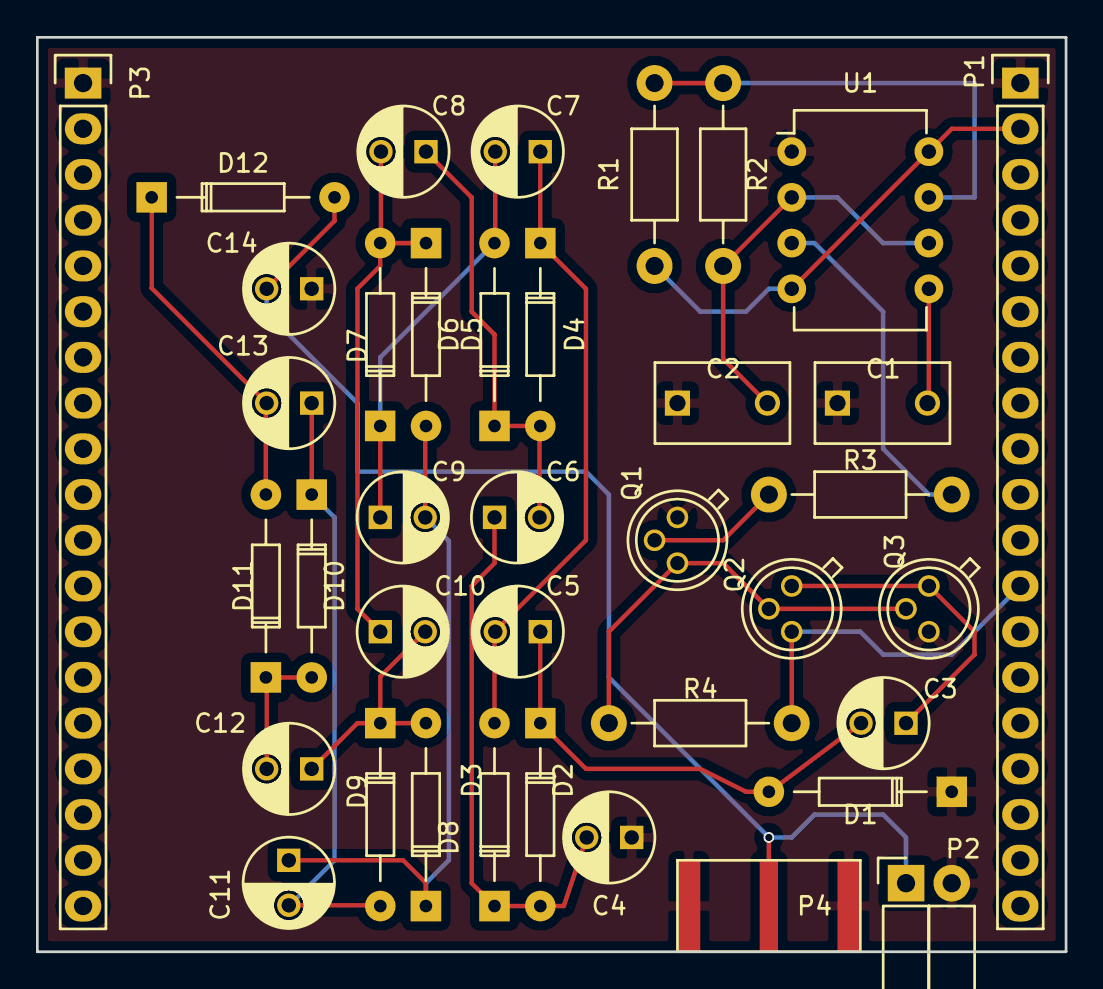
[picture p54: board DB_HV_V1.kicad_pcb from above]

Board: 2 copper layers, 57.2 x 50.8 mm, 38 parts (0 on the bottom side), 22 nets.
