fengecho/electronic/kicad/Daugter_boards/DB_Envelope_detector/V2/DB_Envelope_detector_V2.kicad_pcb

## KiCad design kicad/Daugter_boards/DB_Envelope_detector/V2/DB_Envelope_detector_V2.kicad_pcb (2016-08-17)

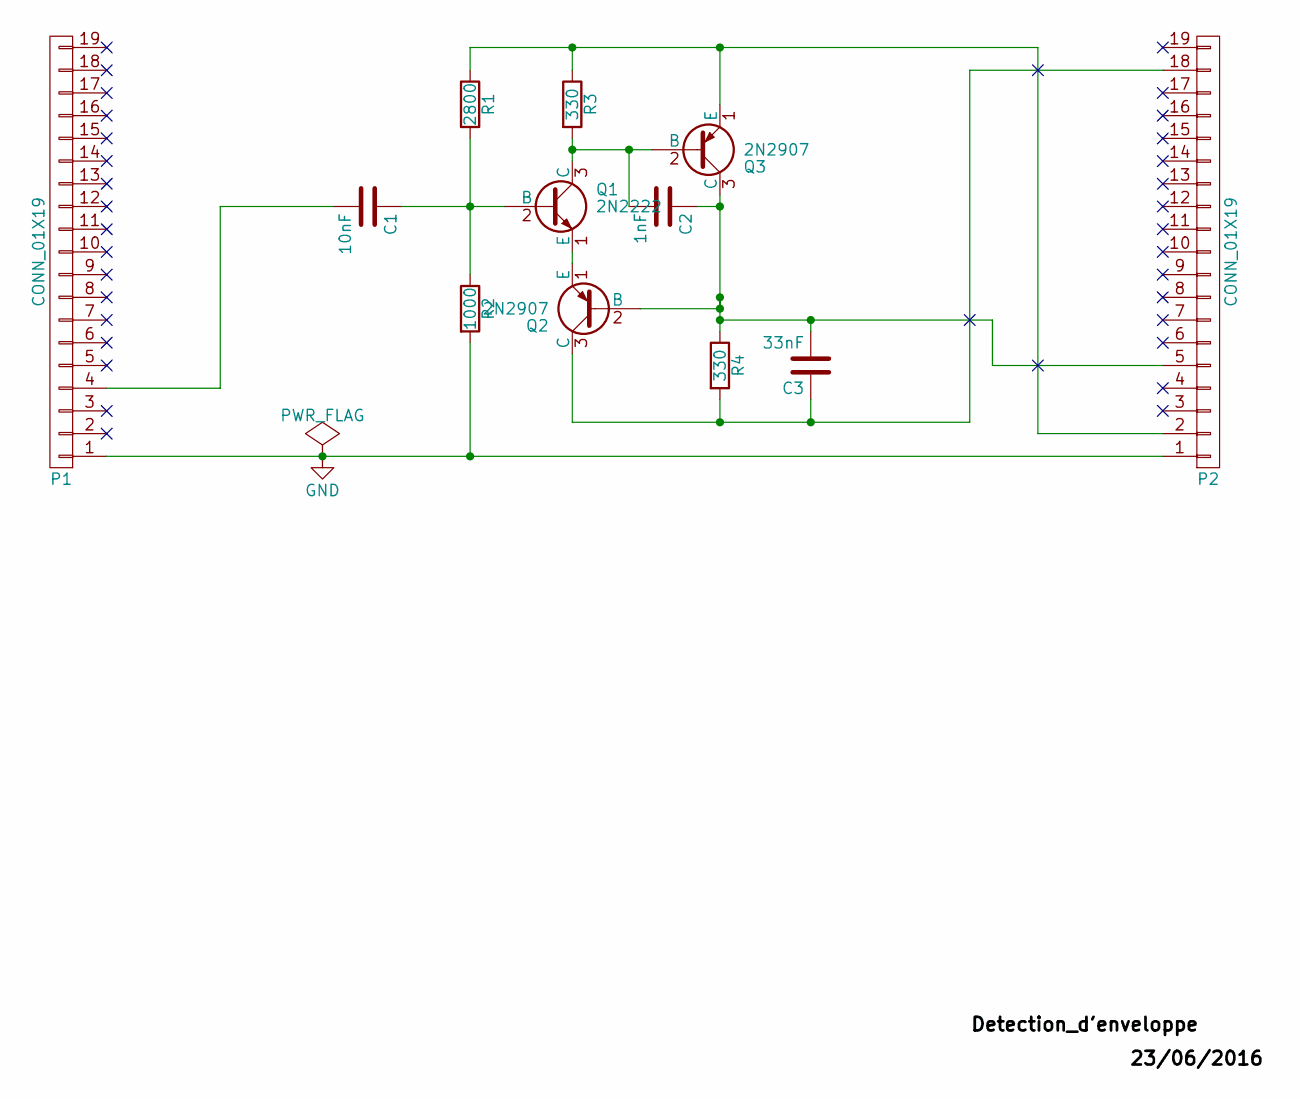
[picture p55: schematic DB_Envelope_detector_V2.sch]

Parts:
C1: 10nF; C_Disc_D6_P5
C2: 1nF; C_Disc_D6_P5
C3: 33nF; C_Disc_D6_P5
P1, P2: CONN_01X19; Socket_Strip_Straight_1x19
Q1: 2N2222; TO-18_3Pin
Q2, Q3: 2N2907; TO-18_3Pin
R1: 2800; Resistor_Ceramic_Horizontal_L19mm-W8mm-H8mm-p25mm
R2: 1000; Resistor_Ceramic_Horizontal_L19mm-W8mm-H8mm-p25mm
R3, R4: 330; Resistor_Ceramic_Horizontal_L19mm-W8mm-H8mm-p25mm

Connections:
GND: P1.1, P2.1, R2.2
unnamed: C1.1, Q1.2 (B), R1.2, R2.1
unnamed: C1.2, P1.4
unnamed: C2.1, C3.2, P2.5, Q2.2 (B), Q3.3 (C), R4.1
unnamed: C2.2, Q1.3 (C), Q3.2 (B), R3.2
unnamed: C3.1, P2.18, Q2.3 (C), R4.2
unnamed: P2.2, Q3.1 (E), R1.1, R3.1
unnamed: Q1.1 (E), Q2.1 (E)

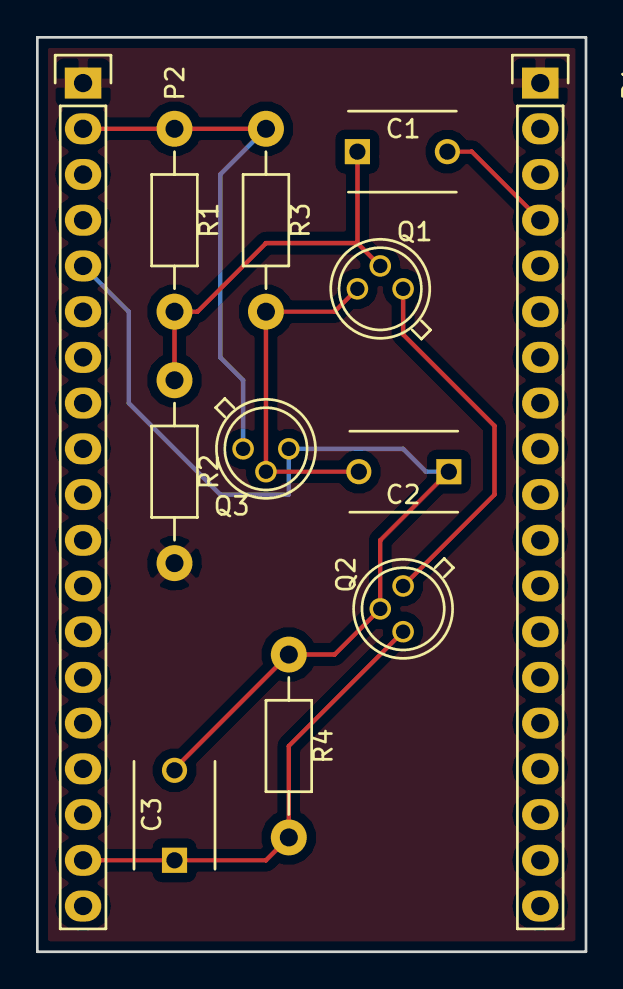
[picture p56: board DB_Envelope_detector_V2.kicad_pcb from above]

Board: 2 copper layers, 30.5 x 50.8 mm, 12 parts (0 on the bottom side), 8 nets.
