fengecho/electronic/kicad/Daugter_boards/DB_Envelope_detector/V1/DB_Envelope_detector_V1.kicad_pcb

## KiCad design kicad/Daugter_boards/DB_Envelope_detector/V1/DB_Envelope_detector_V1.kicad_pcb (2016-08-17, an earlier design)

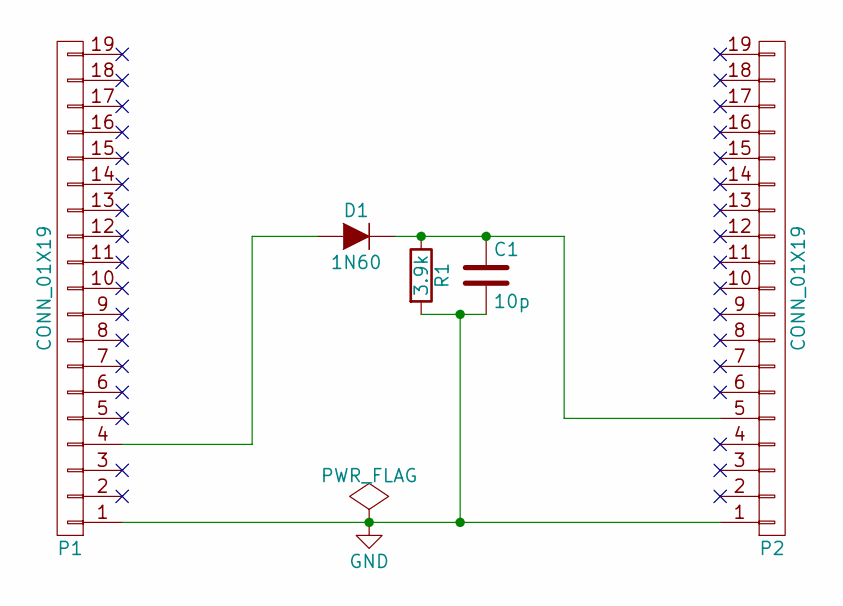
[picture p57: schematic DB_Envelope_detector_V1.sch]

Parts:
C1: 10p; C_Disc_D3_P2.5
D1: 1N60; Diode_DO-35_SOD27_Horizontal_RM10
P1, P2: CONN_01X19; Pin_Header_Straight_1x19
R1: 3.9k; Resistor_Cement_Horizontal_Meggitt-SBC-2

Connections:
GND: C1.2, P1.1, P2.1, R1.2
unnamed: C1.1, D1.1 (K), P2.5, R1.1
unnamed: D1.2 (A), P1.4

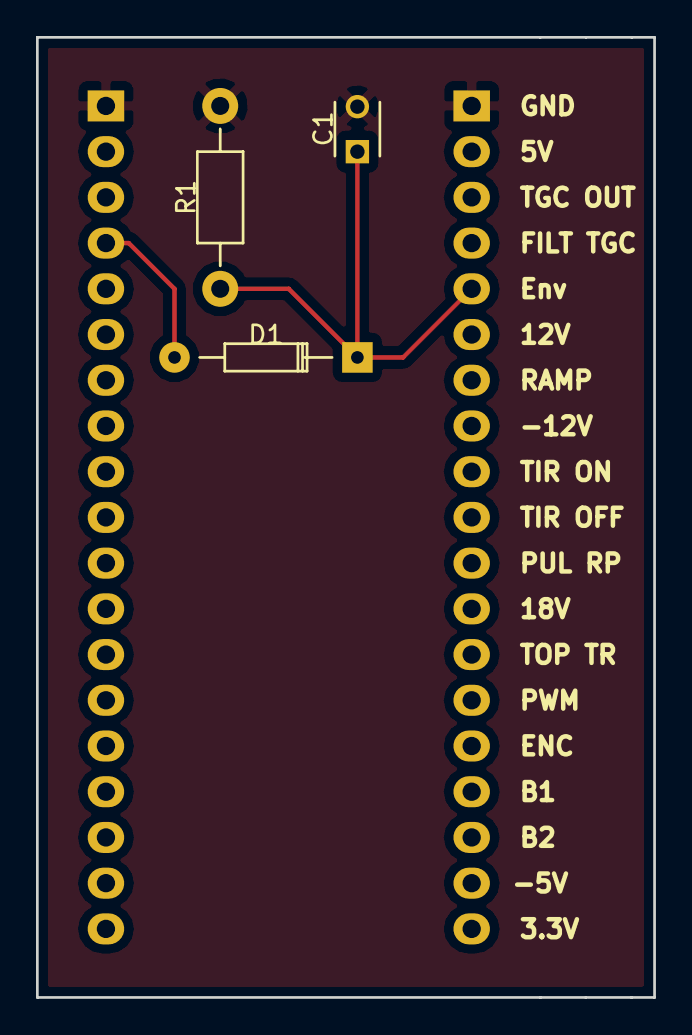
[picture p58: board DB_Envelope_detector_V1.kicad_pcb from above]

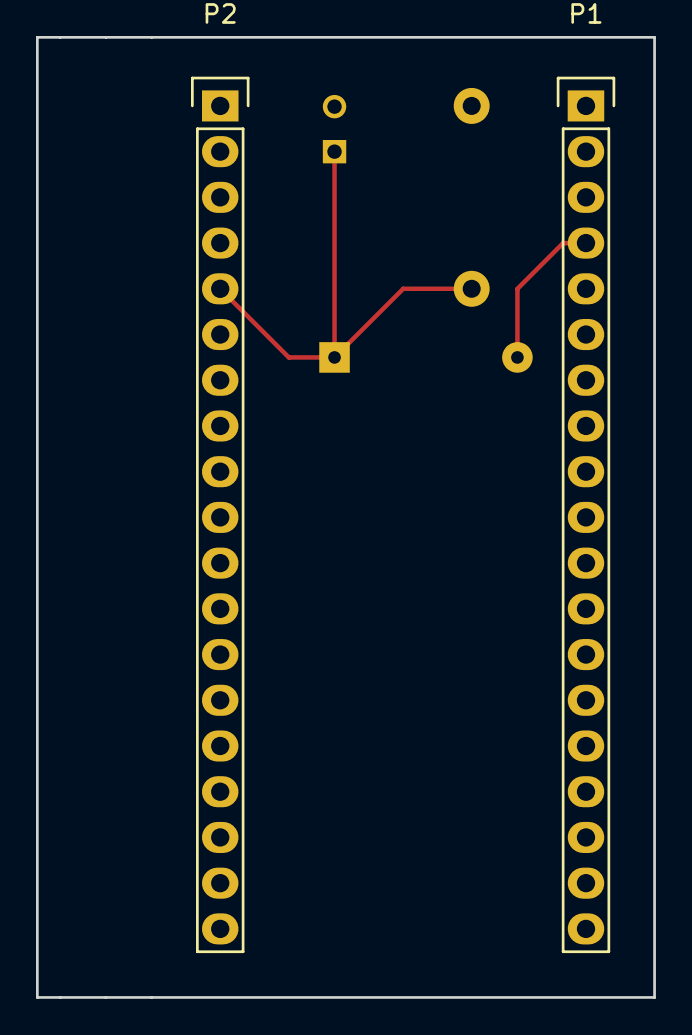
[picture p59: board DB_Envelope_detector_V1.kicad_pcb from below]

Board: 2 copper layers, 34.3 x 53.3 mm, 5 parts (2 on the bottom side), 3 nets.
