fengecho/electronic/kicad/Daugter_boards/DB_Pulser/V1/DB_Pulser_V1.kicad_pcb

## KiCad design kicad/Daugter_boards/DB_Pulser/V1/DB_Pulser_V1.kicad_pcb (2016-08-17, an earlier design)

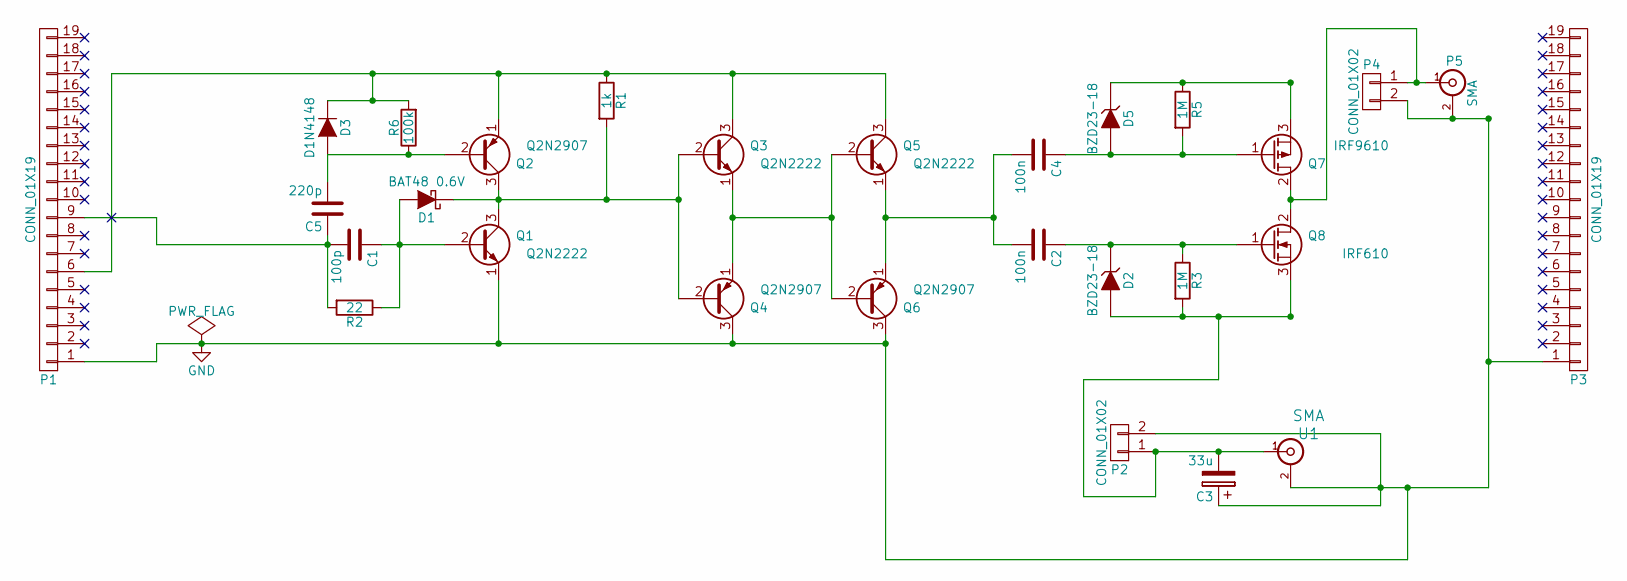
[picture p60: schematic DB_Pulser_V1.sch]

Parts:
C1: 100p; C_Disc_D3_P2.5
C2, C4: 100n; C_Disc_D3_P2.5
C3: 33u; C_Radial_D10_L13_P5
C5: 220p; C_Disc_D3_P2.5
D1: BAT48 0.6V; Diode_DO-35_SOD27_Horizontal_RM10
D2, D5: BZD23-18; SMB_Straight
D3: D1N4148; Diode_DO-35_SOD27_Horizontal_RM10
P1, P3: CONN_01X19; Socket_Strip_Straight_1x19
P2, P4: CONN_01X02; Socket_Strip_Angled_1x02
P5: SMA
Q1, Q3, Q5: Q2N2222; TO-18_3Pin
Q2, Q4, Q6: Q2N2907; TO-18_3Pin
Q7: IRF9610; TO-220_Neutral123_Vertical
Q8: IRF610; TO-220_Neutral123_Vertical
R1: 1k; Resistor_Horizontal_RM10mm
R2: 22; Resistor_Horizontal_RM10mm
R3, R5: 1M; Resistor_Horizontal_RM10mm
R6: 100k; Resistor_Horizontal_RM10mm
U1: SMA

Connections:
GND: C3.1, P1.1, P2.2, P3.1, P4.2, P5.2 (Ext), Q1.1 (E), Q4.3 (C), Q6.3 (C), U1.2 (Ext)
unnamed: C1.1, D1.2 (A), Q1.2 (B), R2.1
unnamed: C1.2, C5.1, P1.9, R2.2
unnamed: C2.1, D2.1 (K), Q8.1 (G), R3.1
unnamed: C2.2, C4.2, Q5.1 (E), Q6.1 (E)
unnamed: C3.2, D2.2 (A), P2.1, Q8.3 (S), R3.2, U1.1 (In)
unnamed: C4.1, D5.2 (A), Q7.1 (G), R5.2
unnamed: C5.2, D3.2 (A), Q2.2 (B), R6.1
unnamed: D1.1 (K), Q1.3 (C), Q2.3 (C), Q3.2 (B), Q4.2 (B), R1.2
unnamed: D3.1 (K), P1.6, Q2.1 (E), Q3.3 (C), Q5.3 (C), R1.1, R6.2
unnamed: D5.1 (K), Q7.3 (S), R5.1
unnamed: P4.1, P5.1 (In), Q7.2 (D), Q8.2 (D)
unnamed: Q3.1 (E), Q4.1 (E), Q5.2 (B), Q6.2 (B)

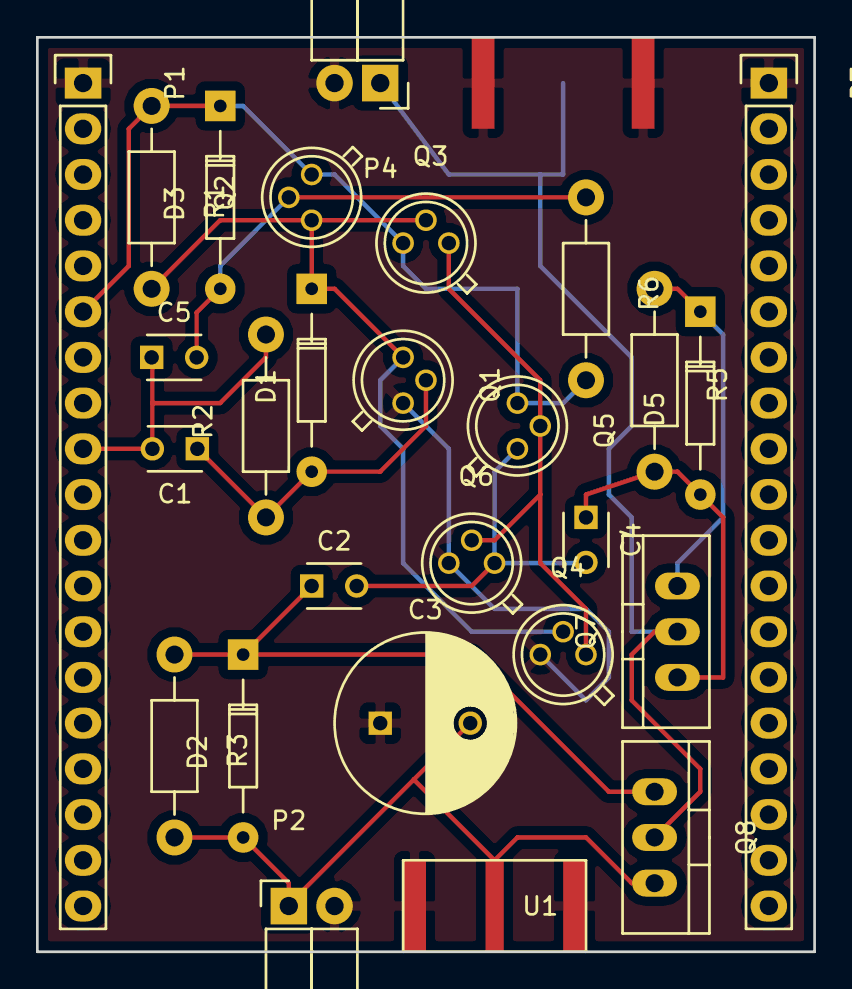
[picture p61: board DB_Pulser_V1.kicad_pcb from above]

Board: 2 copper layers, 43.2 x 50.8 mm, 28 parts (1 on the bottom side), 13 nets.
