fengecho/electronic/(commit log)

2016-06-20 adding the kicad repository
2016-06-21 Ajout du schematic sur kicad du symetric supply
    [proto.csv, proto.kicad_pcb, proto.sch]
2016-06-27 Ajout kicad envelope detector
    [projet.csv, projet.kicad_pcb, projet.sch]
2016-07-06 Schematic in controlling the stepper motor
    [motor project.kicad_pcb, motor project.sch]
2016-07-08 add the schematic of ramp generator with FPGA & the librairy echopen including the schematic of FPGA_pluto and OPA625
    [schema.kicad_pcb, schema.sch]
2016-07-11 modification de la librairie kicad et ajout schematic avec flash board
    [schematic.kicad_pcb, schematic.sch]
2016-07-20 add schematic of the fpga and the dac module
    [schema.csv, schema.kicad_pcb, schema.sch]
2016-07-21 add schematic of the new ramp signal generate with the fpga pluto
    [schema.csv, schema.kicad_pcb, schema.sch]
2016-08-03 changing repository hierarchy
    [Supply_v1_0.kicad_pcb, Supply_v1_0.sch, Supply_v1_0_old.sch, motor project.kicad_pcb, motor project.sch, projet.csv, projet.kicad_pcb, projet.sch]
2016-08-03 creating MDL_Supply
    [DB_Supply_V1.kicad_pcb, DB_Supply_V1.sch]
2016-08-03 adding MDL_HVC
    [MDL_HVC_V1.csv, MDL_HVC_V1.kicad_pcb, MDL_HVC_V1.sch, Supply_v1_0.csv, Supply_v1_0.sch]
2016-08-04 adding MDL_HVC_V2
    [MDL_HVC_V2.csv, MDL_HVC_V2.kicad_pcb, MDL_HVC_V2.sch]
2016-08-04 adding MLD_Pulser_V2
    [MDL_HVC_V2.sch, MDL_Pulser_V2.csv, MDL_Pulser_V2.kicad_pcb, MDL_Pulser_V2.sch]
2016-08-05 adding MDL_Pulser
    [MDL_Pulser_V1.csv, MDL_Pulser_V1.kicad_pcb, MDL_Pulser_V1.sch, MDL_Pulser_V2.sch]
2016-08-05 adding MDL_TR_swithc
    [MDL_TR_switch_V1.kicad_pcb, MDL_TR_switch_V1.sch]
2016-08-05 adding MDL_TGC
    [MDL_TGC_V1.csv, MDL_TGC_V1.kicad_pcb, MDL_TGC_V1.sch, MDL_TR_switch_V1.csv, MDL_TR_switch_V1.sch]
2016-08-05 adding MDL_Filter and MDL_Envelope detector
    [MDL_Envelope_detector_V1.csv, MDL_Envelope_detector_V1.kicad_pcb, MDL_Envelope_detector_V1.sch, MDL_Filter_V1.csv, MDL_Filter_V1.kicad_pcb, MDL_Filter_V1.sch, MDL_Filter_V2.csv, MDL_Filter_V2.kicad_pcb]
2016-08-05 adding MDL_Motor_Control
    [MDL_Motor_V1.kicad_pcb, MDL_Motor_V1.sch, MDL_Motor_V2.kicad_pcb, MDL_Motor_V2.sch, MDL_Motor_control_V1.csv, MDL_Motor_control_V1.kicad_pcb, MDL_Motor_control_V1.sch, MDL_Motor_control_V1.xml]
2016-08-05 update MDL_Ramp
    [schema.csv, schema.sch]
2016-08-08 adding DB_HV
    [DB_HV_V1.csv, DB_HV_V1.kicad_pcb, DB_HV_V1.old.sch, DB_HV_V1.sch, DB_HV_V2.csv, DB_HV_V2.kicad_pcb, DB_HV_V2.sch, DB_HV_V2_old.sch]
2016-08-08 updata motor repository for cloning issu
    [DB_Filter_V1.kicad_pcb, DB_Filter_V1.sch, DB_HV_V1.sch]
2016-08-08 adding DB_Filter
    [DB_Filter_V1.csv, DB_Filter_V1.sch, DB_Filter_V2.csv, DB_Filter_V2.kicad_pcb, DB_Filter_V2.sch, DB_HV_V1.csv, DB_HV_V1.sch, DB_HV_V2.csv]
2016-08-08 adding DB_TRS_TGC
    [DB_TRS_TGC.csv, DB_TRS_TGC.sch, DB_TRS_TGC_V1.kicad_pcb, _saved_DB_TRS_TGC.sch]
2016-08-08 DB envelope detector, motor control, pulser
    [DB_Envelope_detector_V1.sch, DB_Envelope_detector_V2.csv, DB_Envelope_detector_V2.kicad_pcb, DB_Envelope_detector_V2.sch, DB_Motor_control_V1.csv, DB_Motor_control_V1.kicad_pcb, DB_Motor_control_V1.sch, DB_Motor_control_V1.xml]
2016-08-08 db pulser modif
    [DB_Pulser_V1.sch]
2016-08-08 update daugter boards
    [DB_Envelope_detector_V1.sch, DB_Envelope_detector_V2.sch, DB_Motor_control_V1.csv, DB_Motor_control_V1.kicad_pcb, DB_Motor_control_V1.sch, DB_Motor_control_V1.xml, DB_Motor_control_V2.csv, DB_Motor_control_V2.kicad_pcb]
2016-08-09 update MDL_Pulser_V2
    [MDL_HVC_V2.sch, MDL_Pulser_V2.csv, _saved_MDL_Pulser_V2.sch, schema.csv, schema.kicad_pcb, schema.sch]
2016-08-09 adding software modules (flowcharts)
    [_saved_MDL_Pulser_V2.sch, motor project.csv, motor project.sch, motor project.xml, schema.csv, schema.sch]
2016-08-10 adding module software
    [MDL_ucontroler_V1.sch]
2016-08-10 update MDL and DB Supply
    [DB_Supply_V1.csv, DB_Supply_V1.sch, Supply_v1_0.csv, Supply_v1_0.kicad_pcb, Supply_v1_0.sch, Supply_v1_0_old.sch]
2016-08-11 adding mecanical repo
    [DB_Envelope_detector_V1.csv, DB_Envelope_detector_V1.kicad_pcb, MDL_TR_switch_V1.csv, _saved_DB_Envelope_detector_V1.sch]
2016-08-11 adding DB_Envelope_Detector
    [DB_Envelope_detector_V1.kicad_pcb, DB_Envelope_detector_V1.sch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]
2016-08-16 adding gerber files of DB_HV
    [DB_HV_V1.kicad_pcb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]
2016-08-16 adding DB_Motor_Control
    [DB_Motor_control_V1.csv, DB_Motor_control_V1.sch, DB_Motor_control_V1.xml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]
2016-08-16 adding DB_Pulser
    [DB_Pulser_V1.csv, DB_Pulser_V1.sch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]
2016-08-16 update DB_HV_V1
    [DB_HV_V11.kicad_pcb, _saved_DB_HV_V1.sch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]
2016-08-17 update DB_HV, update librairy and librairy path for MDL
    [DB_HV_V1.csv, DB_HV_V1.kicad_pcb, DB_HV_V1.sch, DB_Link.csv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]
2016-08-17 update figures and nomenclature of MDLs
    [MDL_HVC_V1.csv, MDL_HVC_V1.sch, MDL_Motor_control_V1.csv, MDL_Motor_control_V1.xml]
2016-08-17 update DB_Envelope_Detector with correct librairy and footprint
    [DB_Envelope_detector_V1.kicad_pcb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]
2016-08-17 update librairy with correct nomenclature of transistor
    [DB_Envelope_detector_V2.csv, DB_Envelope_detector_V2.kicad_pcb, DB_Envelope_detector_V2.sch]
2016-08-17 update DB_Envelope_Detector design
    [DB_Envelope_detector_V1.kicad_pcb, DB_Envelope_detector_V2.kicad_pcb]
2016-08-17 update echopen footprint librairy for better finish
    [DB_Filter_V1.kicad_pcb]
2016-08-17 update MDLs with new librairy
    [MDL_HVC_V1.csv, MDL_HVC_V1.sch, MDL_Motor_control_V1.csv, MDL_Motor_control_V1.sch, MDL_Motor_control_V1.xml, MDL_Pulser_V1.csv, MDL_Pulser_V1.sch, Supply_v1_0.csv]
2016-08-18 inverting SMA layer position and improve finish of DB_HV
    [DB_HV_V1.kicad_pcb, DB_HV_V2.kicad_pcb]
2016-08-18 improve DB_Filter finish
    [DB_Filter_V1.kicad_pcb]
2016-08-18 improve DB_Mother_Board finish
    [DB_Link.kicad_pcb]
2016-08-18 change nomenclature of DB_Mother_Board
    [DB_Mother_Board.csv, DB_Mother_Board.kicad_pcb, DB_Mother_Board.sch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]
2016-08-18 correct non connected pin on DB_HV
    [DB_HV_V2.kicad_pcb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]
2016-08-18 the source for 3DPrinting
    [beam_a.igs, beam_b.igs, demonstration_with_all_components.igs, gyroscope_support_a.igs, gyroscope_support_b.igs, joint_between_motor_and_metal_rod.igs, metal_plate_support01.igs, metal_plate_support02.igs]
